electrocifiligrama/ASSD-TP3/sigmaDelta/sigmaDeltaAltium/Project Outputs for sigmaDeltaAltium/Board Information - sigmaDelta.txt

Board Information Report
Filename     : C:\Users\malen\Desktop\ASSD\TP3aux\sigmaDeltaAltium\sigmaDelta.PcbDoc
Date         : 27/5/2019
Time         : 15:24:40
Time Elapsed : 00:00:00

General
    Board Size, 152.4mmx101.6mm
    Components on board, 68
count : 2

Routing Information
    Routing completion, 97,11%
    Connections, 173
    Connections routed, 168
    Connections remaining, 5
count : 4
