electrocifiligrama/ASSD-TP3/sigmaDelta/sigmaDeltaAltium/Project Outputs for sigmaDeltaAltium/Board Information - sigmaDeltaAUX.txt

Board Information Report
Filename     : C:\Users\malen\Desktop\ASSD\TP3aux\sigmaDeltaAltium\sigmaDeltaAUX.PcbDoc
Date         : 29/5/2019
Time         : 09:48:44
Time Elapsed : 00:00:00

General
    Board Size, 100mmx100.07mm
    Components on board, 68
count : 2

Routing Information
    Routing completion, 100,00%
    Connections, 173
    Connections routed, 173
    Connections remaining, 0
count : 4
