electrocifiligrama/ASSD-TP3/informe/filtros/caps.PNG

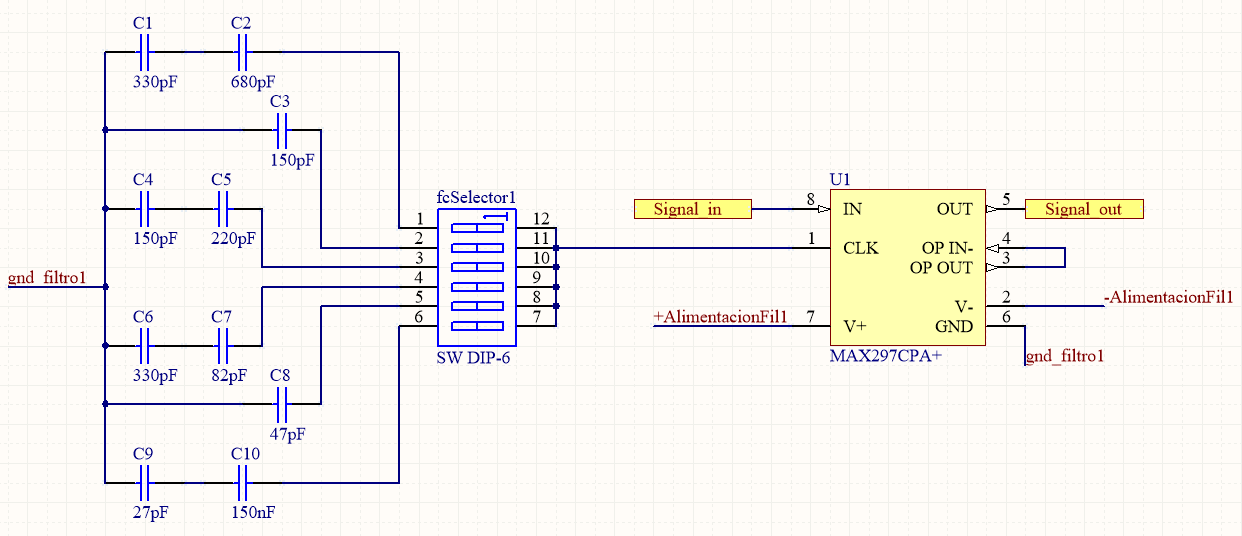
informe/filtros/caps.PNG
