electrocifiligrama/ASSD-TP3/informe/filtros/datosfiltro.PNG

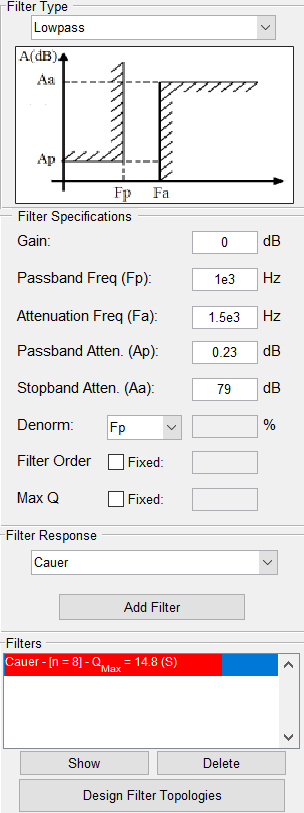
informe/filtros/datosfiltro.PNG
