electrocifiligrama/ASSD-TP3/informe/filtros/ellipticFilterResponse.PNG

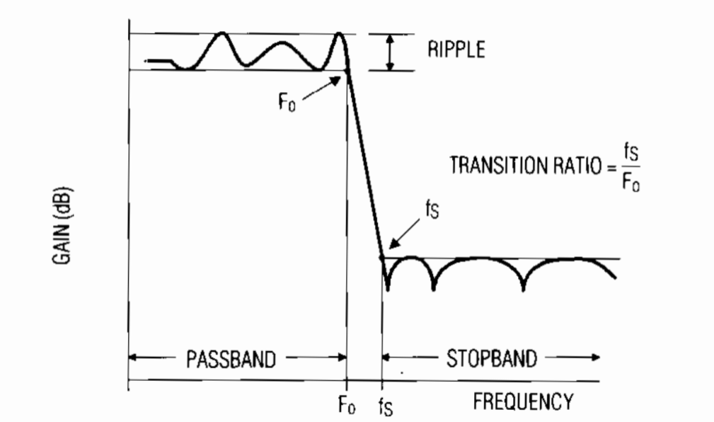
informe/filtros/ellipticFilterResponse.PNG
