electrocifiligrama/ASSD-TP3/informe/filtros/freqResponse.PNG

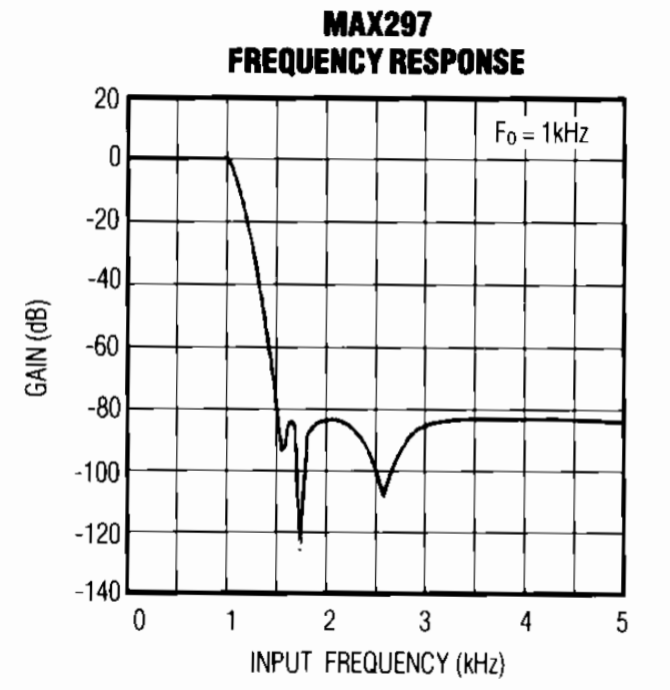
informe/filtros/freqResponse.PNG
