electrocifiligrama/ASSD-TP3/informe/filtros/magbode.PNG

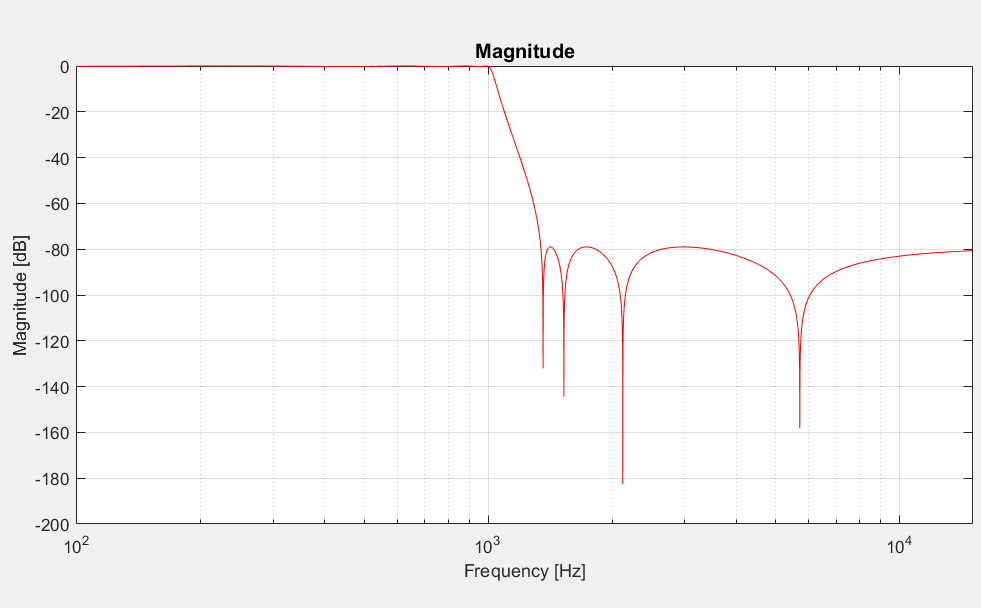
informe/filtros/magbode.PNG
