electrocifiligrama/ASSD-TP3/informe/filtros/magbodeZoom.PNG

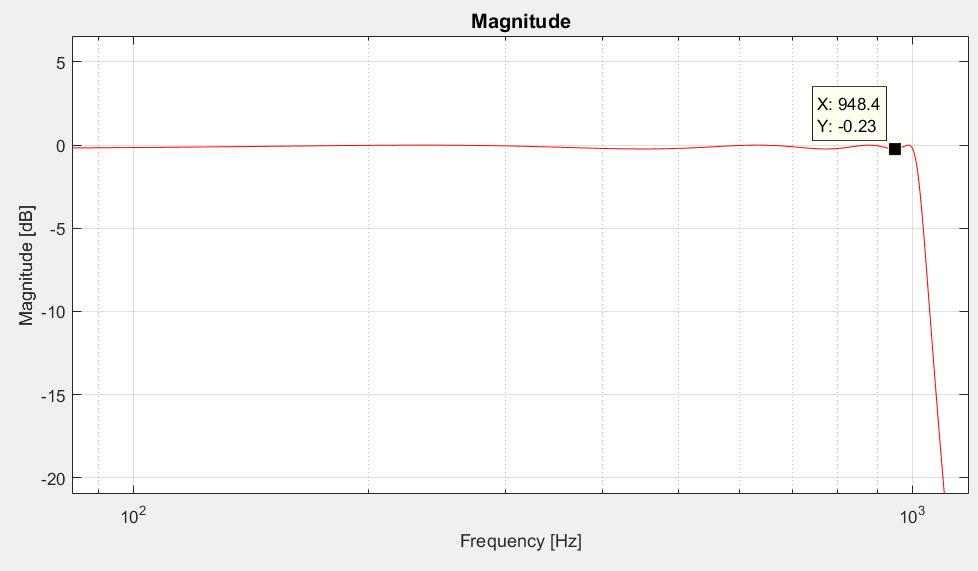
informe/filtros/magbodeZoom.PNG
