electrocifiligrama/ASSD-TP3/informe/filtros/phasebode.PNG

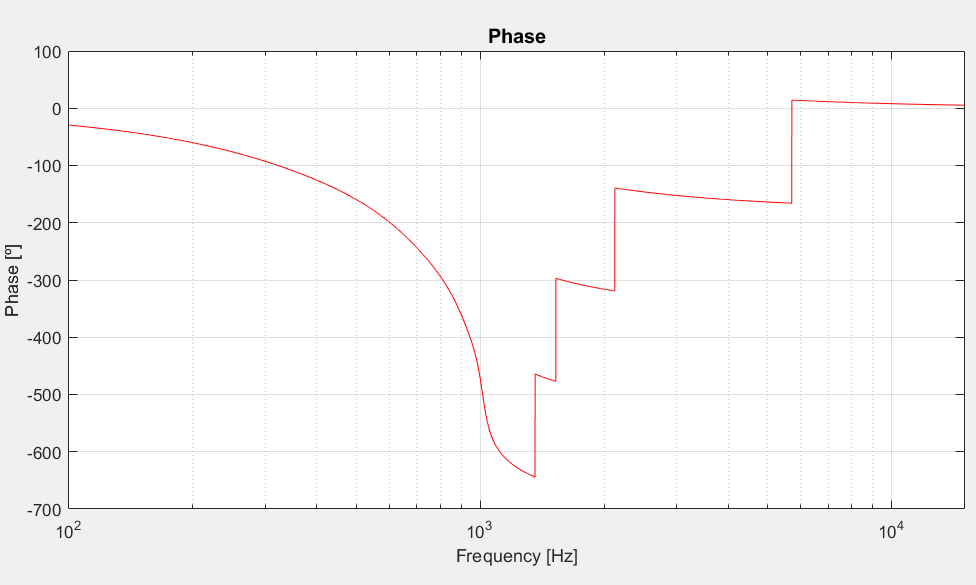
informe/filtros/phasebode.PNG
