electrocifiligrama/ASSD-TP3/informe/filtros/phaseResponse.PNG

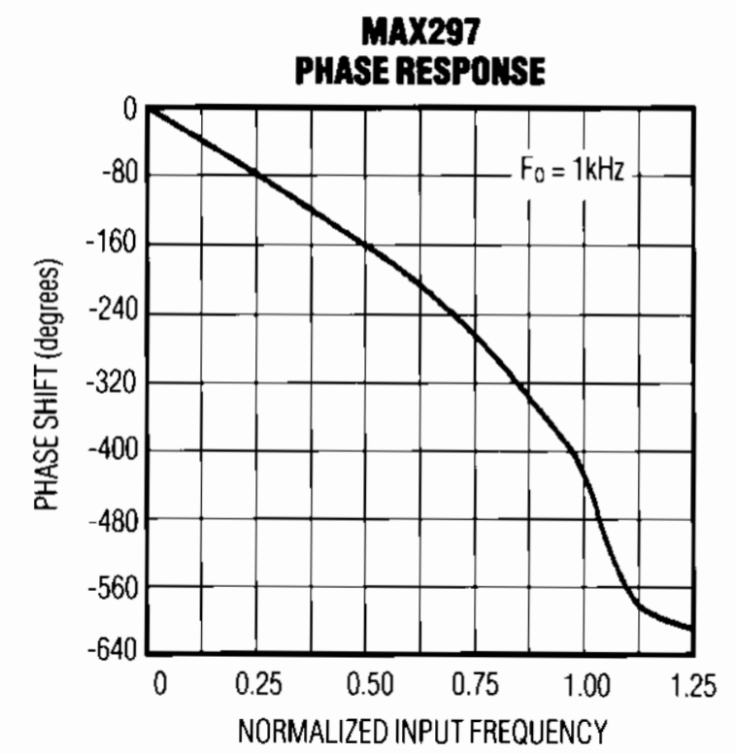
informe/filtros/phaseResponse.PNG
