electrocifiligrama/ASSD-TP3/informe/filtros/polezeromap.PNG

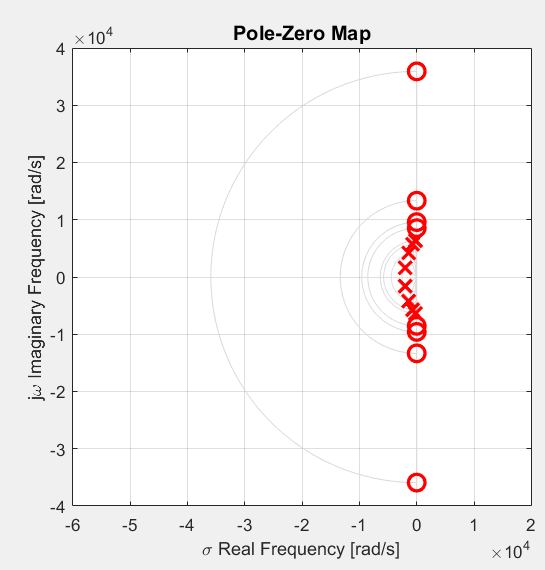
informe/filtros/polezeromap.PNG
