electrocifiligrama/ASSD-TP3/informe/imagenes/ada.PNG

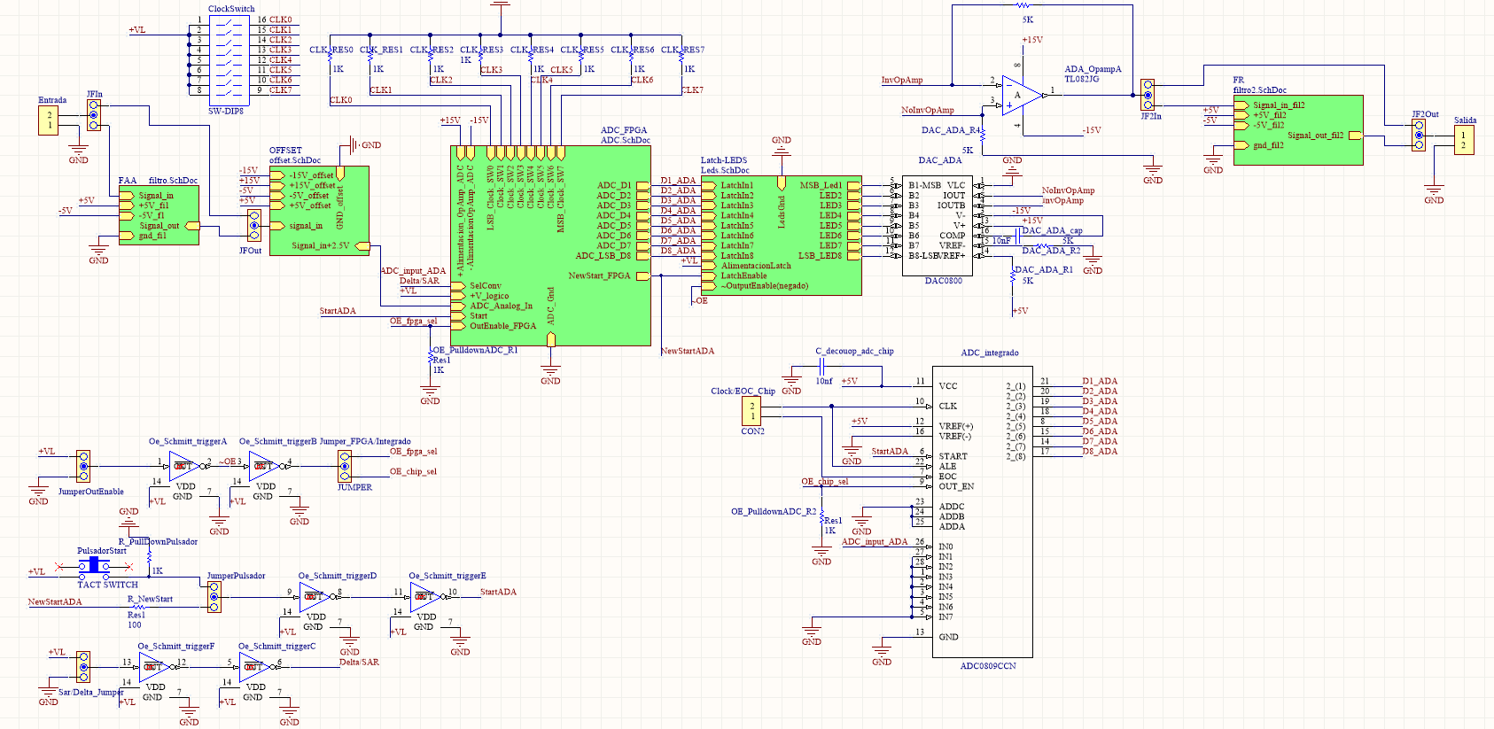
informe/imagenes/ada.PNG
