electrocifiligrama/ASSD-TP3/informe/imagenes/dacOut.PNG

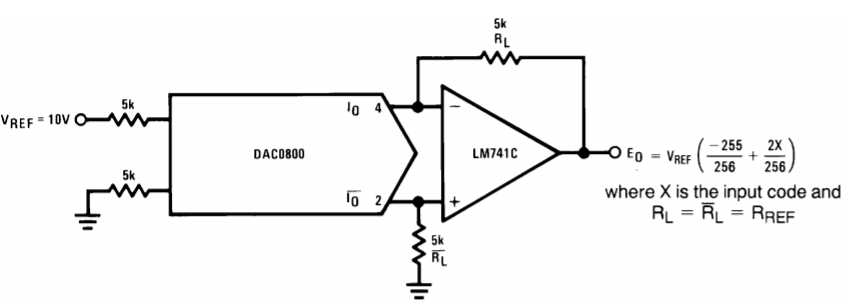
informe/imagenes/dacOut.PNG
