electrocifiligrama/ASSD-TP3/informe/imagenes/offset.PNG

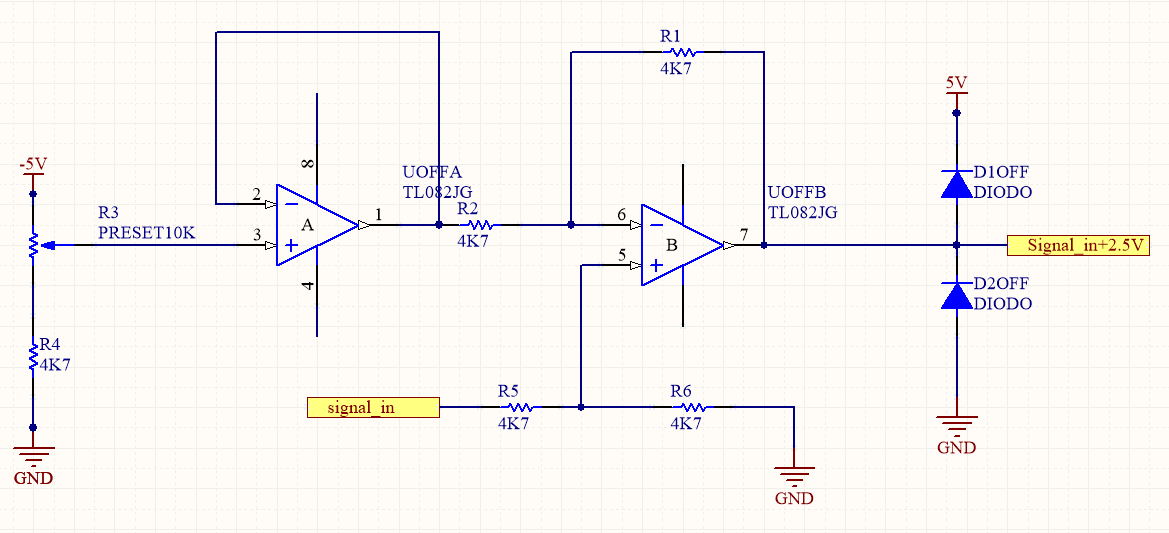
informe/imagenes/offset.PNG
