electrocifiligrama/ASSD-TP3/informe/imagenes/Screenshot 2019-06-12 13.05.55.png

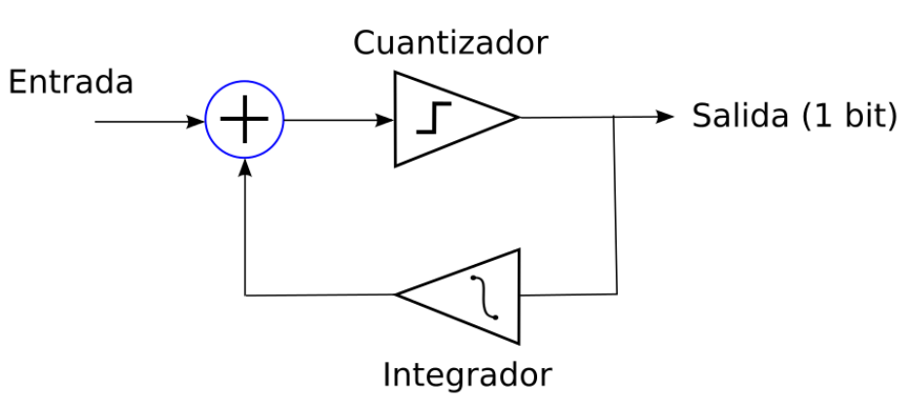
informe/imagenes/Screenshot 2019-06-12 13.05.55.png
