electrocifiligrama/ASSD-TP3/informe/imagenes/Screenshot 2019-06-12 13.13.50.png

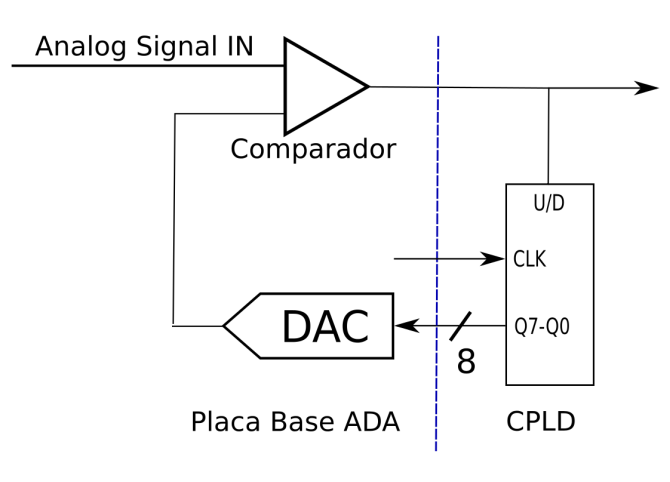
informe/imagenes/Screenshot 2019-06-12 13.13.50.png
