electrocifiligrama/ASSD-TP3/SAR/Informe/Imágenes/bits_notacion.png

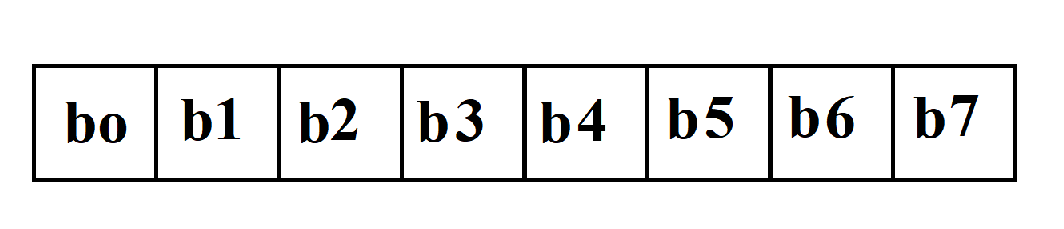
SAR/Informe/Imágenes/bits_notacion.png
