electrocifiligrama/ASSD-TP3/SAR/Informe/Imágenes/sample_hold_times.png

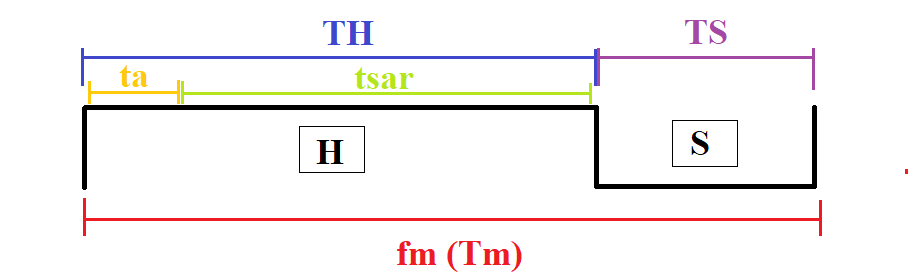
SAR/Informe/Imágenes/sample_hold_times.png
