electrocifiligrama/ASSD-TP3/SAR/Informe/Imágenes/sample_hold_times_final.png

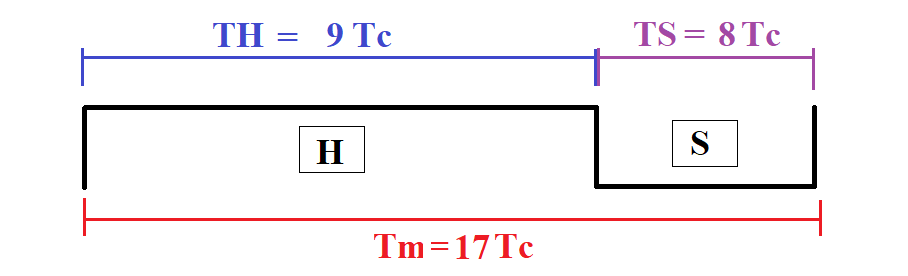
SAR/Informe/Imágenes/sample_hold_times_final.png
