electrocifiligrama/ASSD-TP3/sigmaDelta/imagenesSIGMADELTA/decimadorFIR.PNG

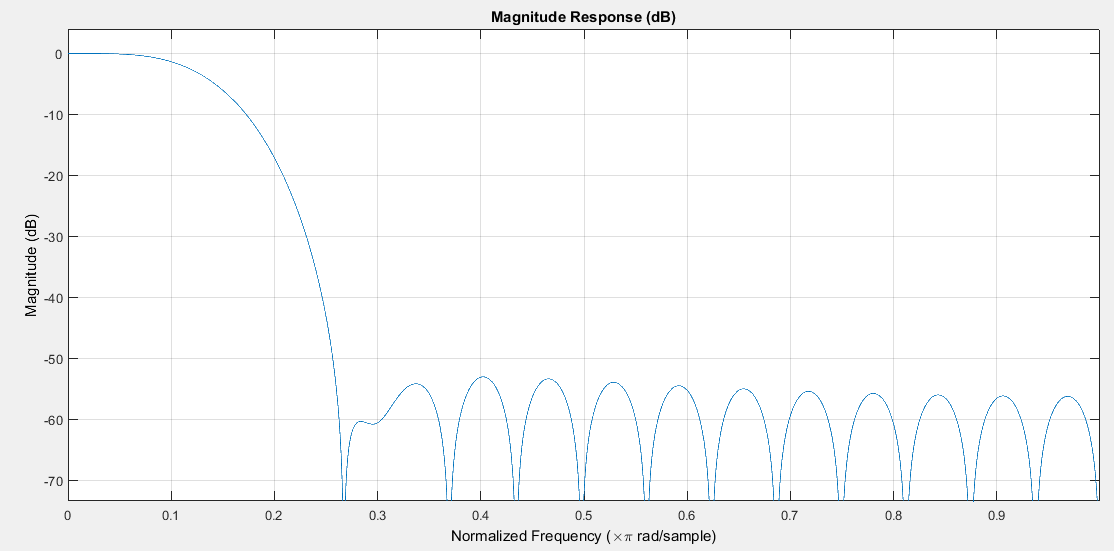
sigmaDelta/imagenesSIGMADELTA/decimadorFIR.PNG
