electrocifiligrama/ASSD-TP3/sigmaDelta/imagenesSIGMADELTA/delta2sigmadelta1.PNG

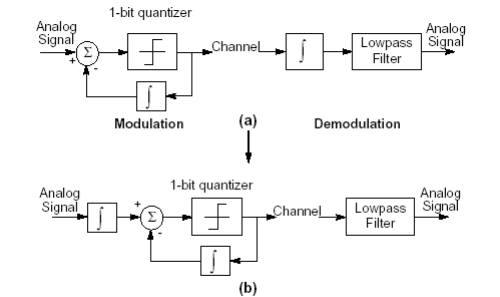
sigmaDelta/imagenesSIGMADELTA/delta2sigmadelta1.PNG
