electrocifiligrama/ASSD-TP3/sigmaDelta/imagenesSIGMADELTA/delta2sigmadelta2.PNG

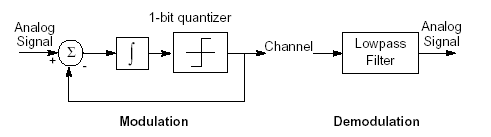
sigmaDelta/imagenesSIGMADELTA/delta2sigmadelta2.PNG
