electrocifiligrama/ASSD-TP3/sigmaDelta/imagenesSIGMADELTA/espectroMedioGauss.PNG

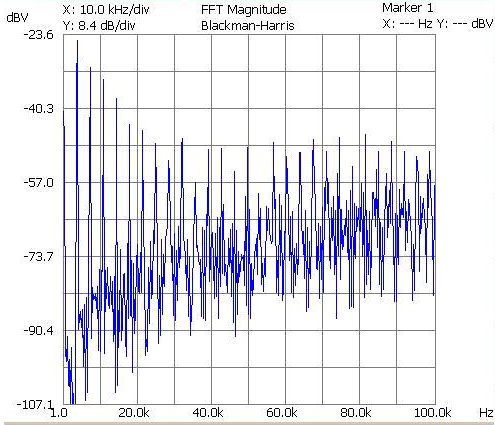
sigmaDelta/imagenesSIGMADELTA/espectroMedioGauss.PNG
