electrocifiligrama/ASSD-TP3/sigmaDelta/imagenesSIGMADELTA/espectroSen1KHzSimulink.PNG

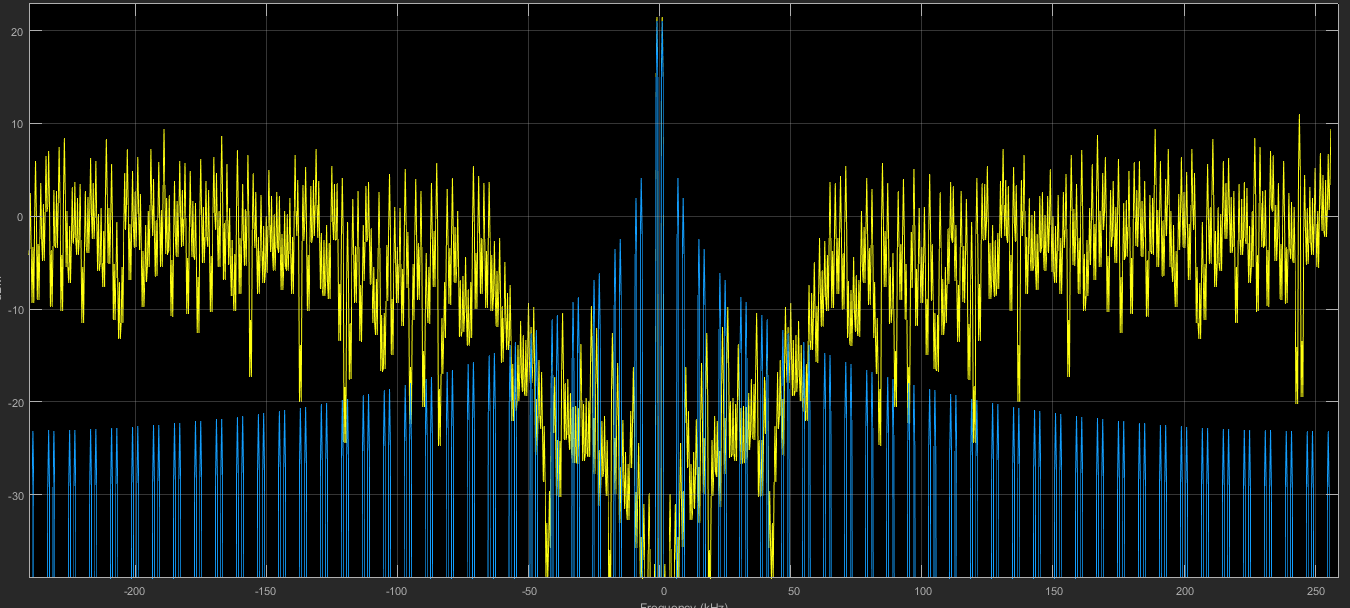
sigmaDelta/imagenesSIGMADELTA/espectroSen1KHzSimulink.PNG
