electrocifiligrama/ASSD-TP3/sigmaDelta/imagenesSIGMADELTA/espectroSeno.PNG

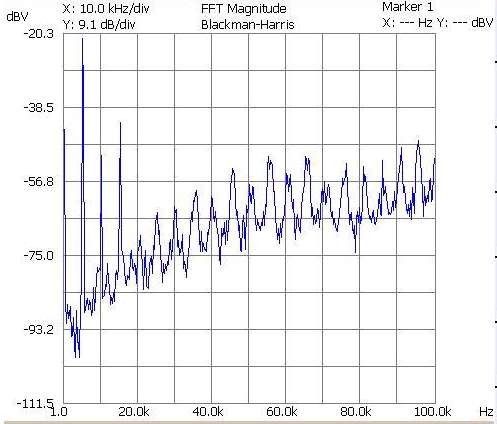
sigmaDelta/imagenesSIGMADELTA/espectroSeno.PNG
