electrocifiligrama/ASSD-TP3/sigmaDelta/imagenesSIGMADELTA/espectroShaped.PNG

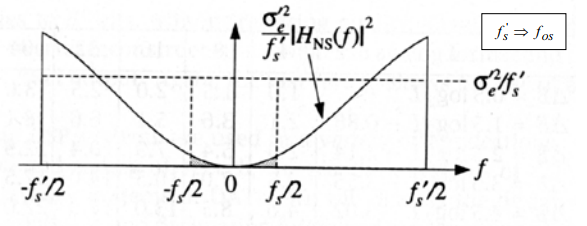
sigmaDelta/imagenesSIGMADELTA/espectroShaped.PNG
