electrocifiligrama/ASSD-TP3/sigmaDelta/imagenesSIGMADELTA/espectroSimulink.PNG

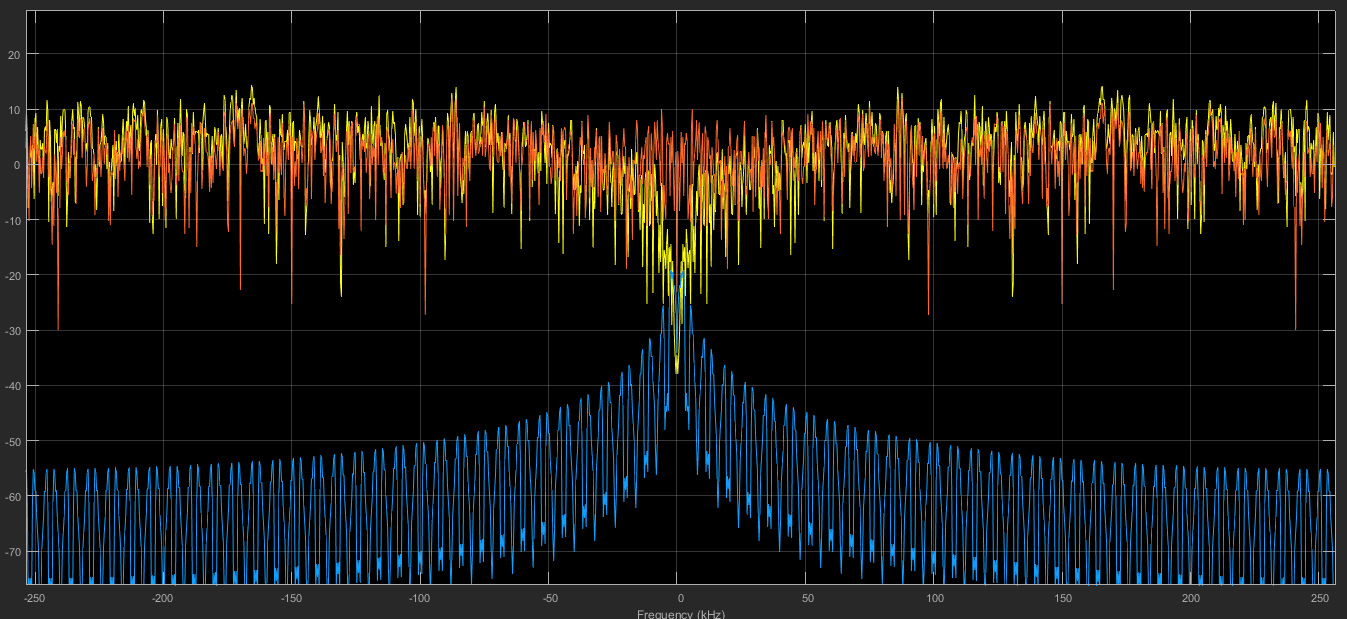
sigmaDelta/imagenesSIGMADELTA/espectroSimulink.PNG
