electrocifiligrama/ASSD-TP3/sigmaDelta/imagenesSIGMADELTA/espectroSinc.PNG

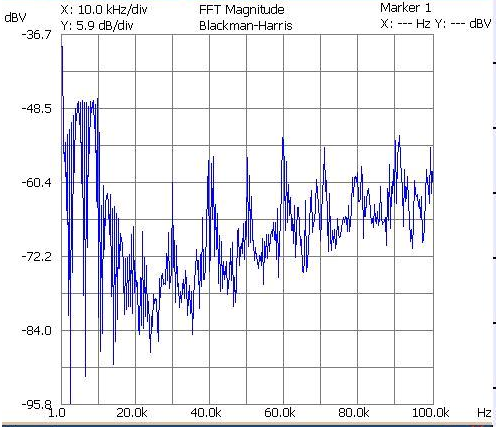
sigmaDelta/imagenesSIGMADELTA/espectroSinc.PNG
