electrocifiligrama/ASSD-TP3/sigmaDelta/imagenesSIGMADELTA/esquemaSIMULINK.PNG

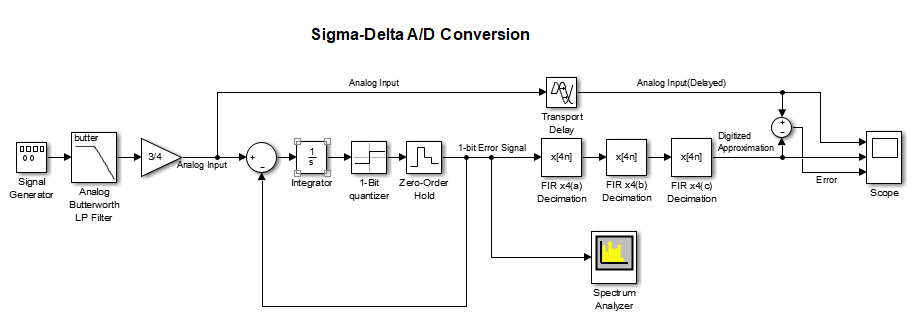
sigmaDelta/imagenesSIGMADELTA/esquemaSIMULINK.PNG
