electrocifiligrama/ASSD-TP3/sigmaDelta/imagenesSIGMADELTA/esquematicoBASE.png

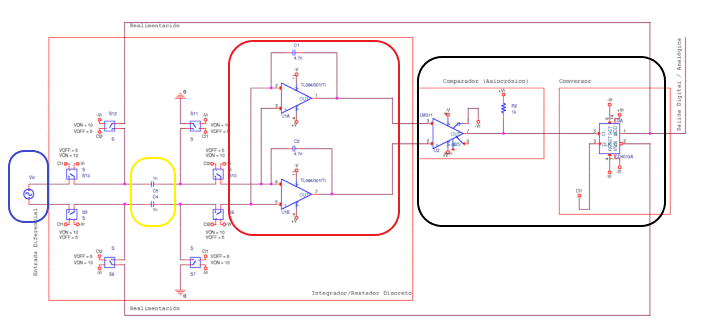
sigmaDelta/imagenesSIGMADELTA/esquematicoBASE.png
