electrocifiligrama/ASSD-TP3/sigmaDelta/imagenesSIGMADELTA/esquematicoBASEsincuadros.PNG

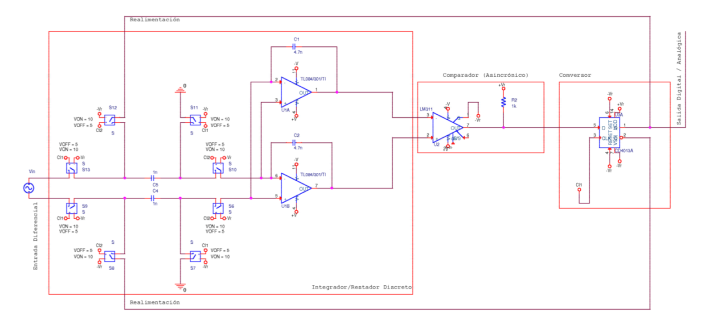
sigmaDelta/imagenesSIGMADELTA/esquematicoBASEsincuadros.PNG
