electrocifiligrama/ASSD-TP3/sigmaDelta/imagenesSIGMADELTA/esquematicoClock.PNG

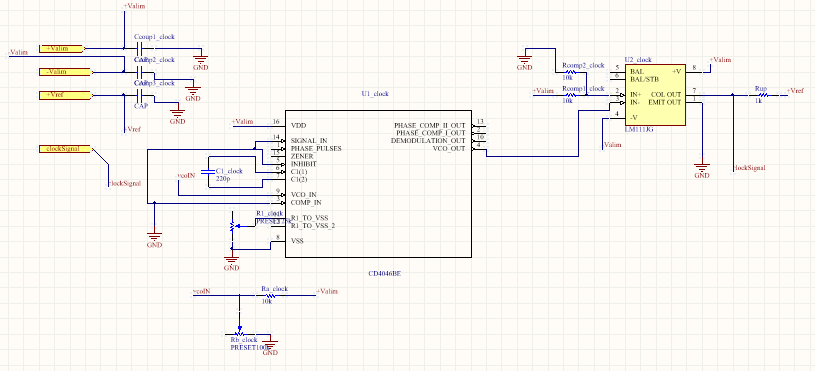
sigmaDelta/imagenesSIGMADELTA/esquematicoClock.PNG
