electrocifiligrama/ASSD-TP3/sigmaDelta/imagenesSIGMADELTA/esquematicoDiff.PNG

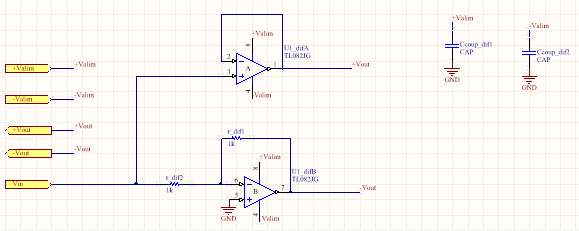
sigmaDelta/imagenesSIGMADELTA/esquematicoDiff.PNG
