electrocifiligrama/ASSD-TP3/sigmaDelta/imagenesSIGMADELTA/esquematicoFiltros.PNG

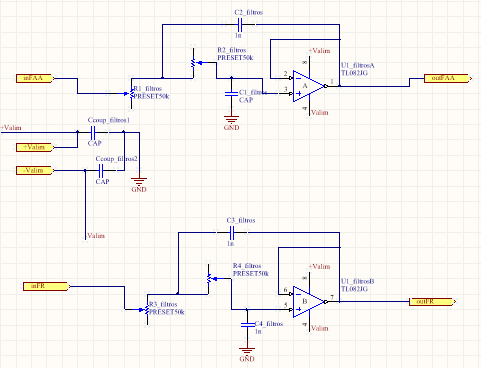
sigmaDelta/imagenesSIGMADELTA/esquematicoFiltros.PNG
