electrocifiligrama/ASSD-TP3/sigmaDelta/imagenesSIGMADELTA/esquematicoGeneral.PNG

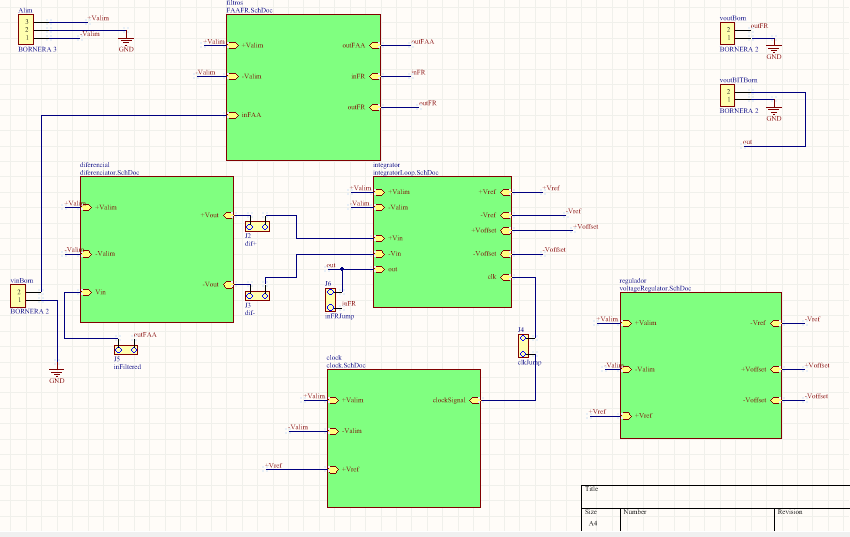
sigmaDelta/imagenesSIGMADELTA/esquematicoGeneral.PNG
