electrocifiligrama/ASSD-TP3/sigmaDelta/imagenesSIGMADELTA/esquematicoGenVref.PNG

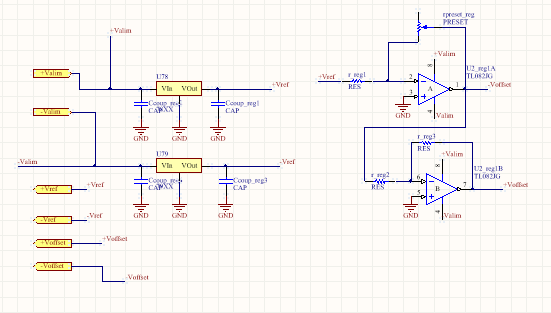
sigmaDelta/imagenesSIGMADELTA/esquematicoGenVref.PNG
