electrocifiligrama/ASSD-TP3/sigmaDelta/imagenesSIGMADELTA/esquematicoIntegrador.PNG

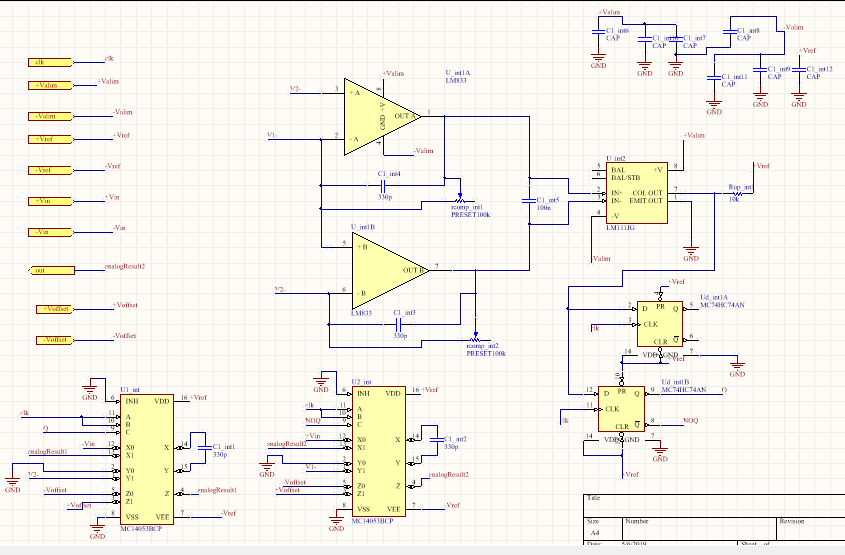
sigmaDelta/imagenesSIGMADELTA/esquematicoIntegrador.PNG
