electrocifiligrama/ASSD-TP3/sigmaDelta/imagenesSIGMADELTA/impulseResponseSimulink.PNG

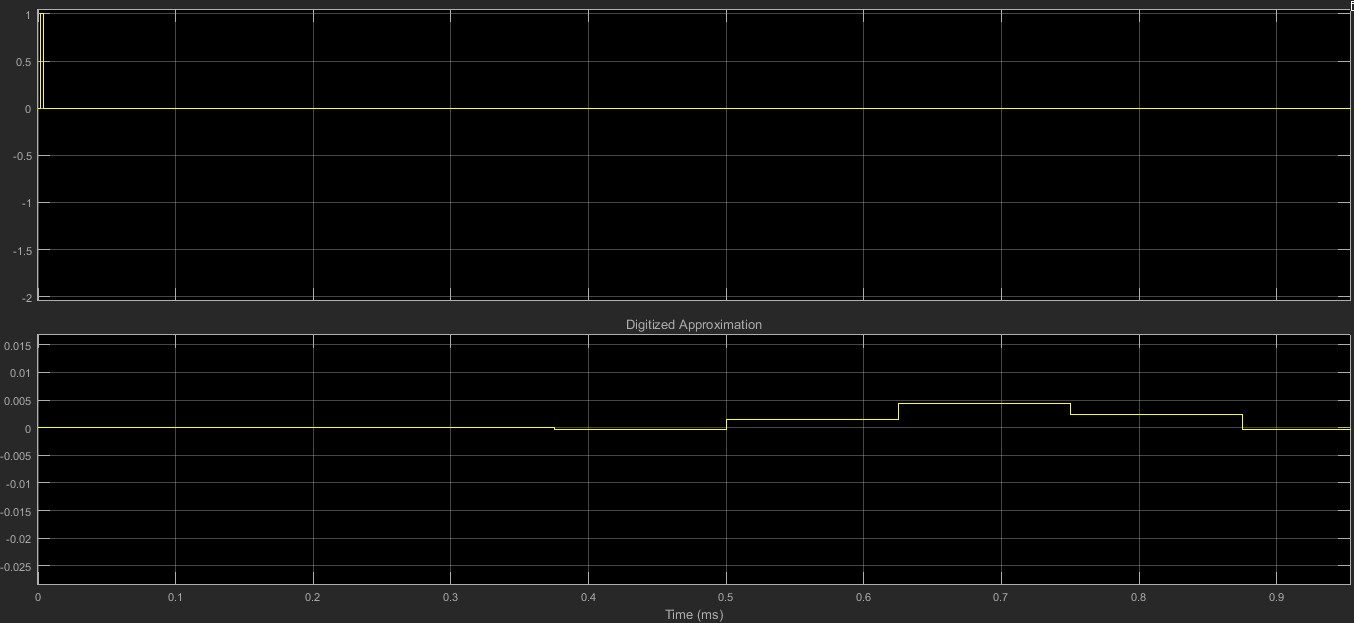
sigmaDelta/imagenesSIGMADELTA/impulseResponseSimulink.PNG
