electrocifiligrama/ASSD-TP3/sigmaDelta/imagenesSIGMADELTA/integradorConRes.PNG

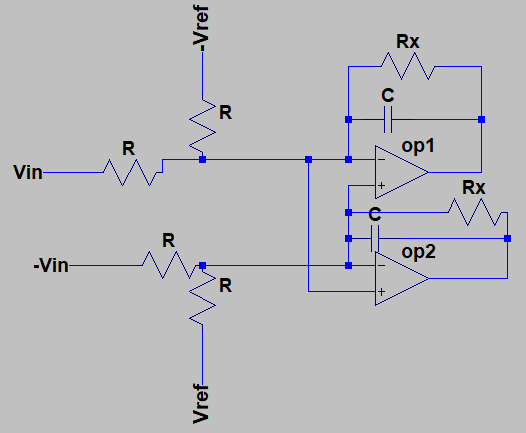
sigmaDelta/imagenesSIGMADELTA/integradorConRes.PNG
