electrocifiligrama/ASSD-TP3/sigmaDelta/imagenesSIGMADELTA/intFinal.PNG

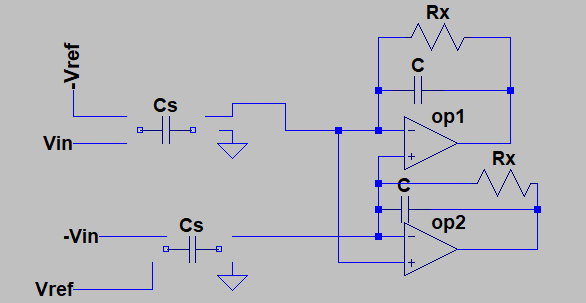
sigmaDelta/imagenesSIGMADELTA/intFinal.PNG
