electrocifiligrama/ASSD-TP3/sigmaDelta/imagenesSIGMADELTA/intHold.PNG

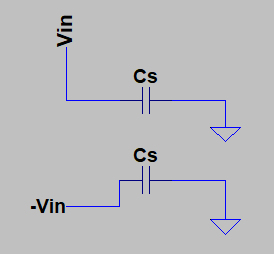
sigmaDelta/imagenesSIGMADELTA/intHold.PNG
