electrocifiligrama/ASSD-TP3/sigmaDelta/imagenesSIGMADELTA/intSample.PNG

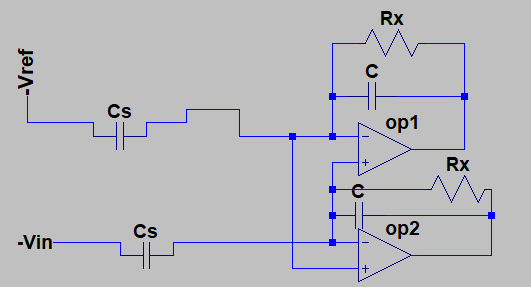
sigmaDelta/imagenesSIGMADELTA/intSample.PNG
