electrocifiligrama/ASSD-TP3/sigmaDelta/imagenesSIGMADELTA/mathModelDiagram.PNG

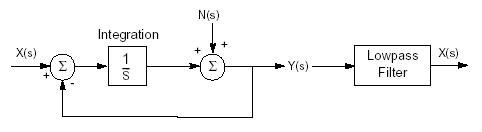
sigmaDelta/imagenesSIGMADELTA/mathModelDiagram.PNG
