electrocifiligrama/ASSD-TP3/sigmaDelta/imagenesSIGMADELTA/medioGaussAlias.PNG

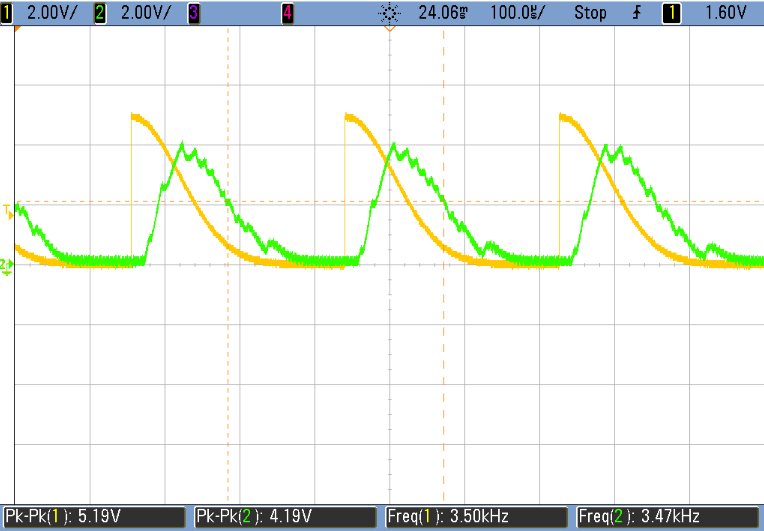
sigmaDelta/imagenesSIGMADELTA/medioGaussAlias.PNG
