electrocifiligrama/ASSD-TP3/sigmaDelta/imagenesSIGMADELTA/medioGaussAverage8.PNG

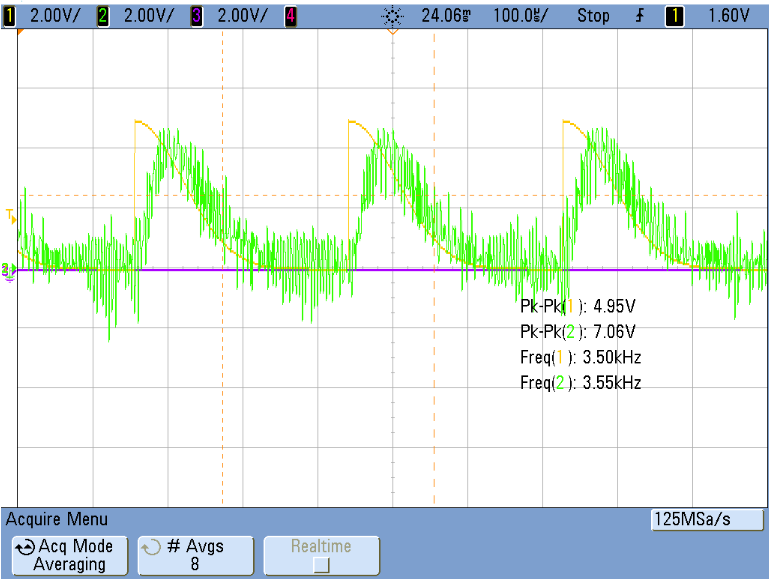
sigmaDelta/imagenesSIGMADELTA/medioGaussAverage8.PNG
