electrocifiligrama/ASSD-TP3/sigmaDelta/imagenesSIGMADELTA/medioGaussAverage4096.PNG

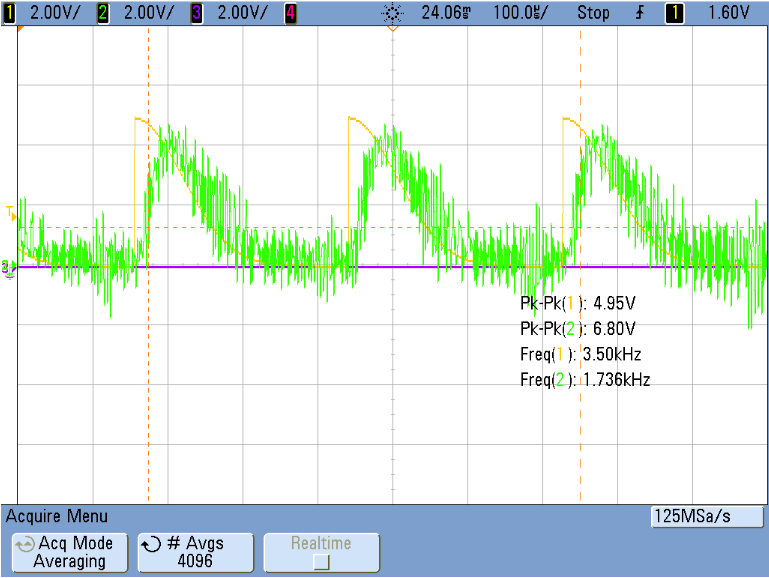
sigmaDelta/imagenesSIGMADELTA/medioGaussAverage4096.PNG
