electrocifiligrama/ASSD-TP3/sigmaDelta/imagenesSIGMADELTA/medioGaussBajaFreq.PNG

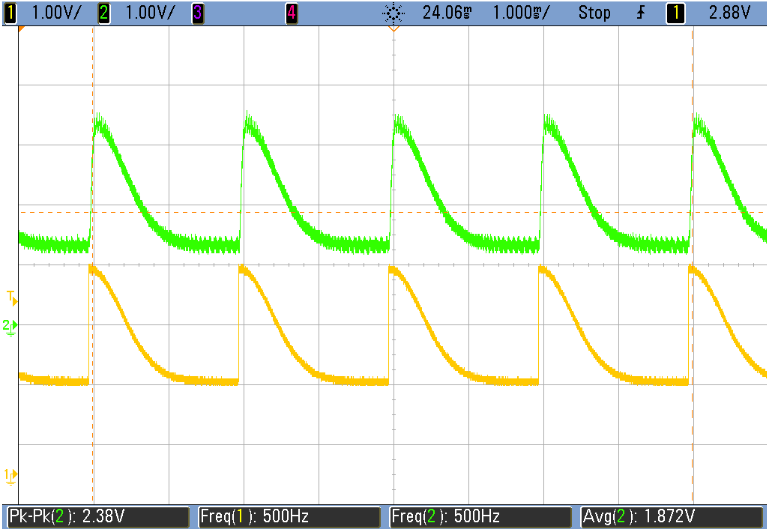
sigmaDelta/imagenesSIGMADELTA/medioGaussBajaFreq.PNG
