electrocifiligrama/ASSD-TP3/sigmaDelta/imagenesSIGMADELTA/medioGaussDifInt.PNG

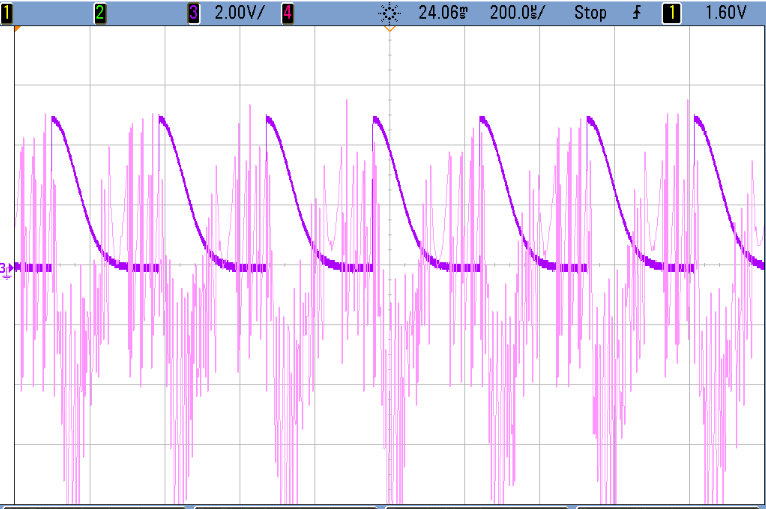
sigmaDelta/imagenesSIGMADELTA/medioGaussDifInt.PNG
