electrocifiligrama/ASSD-TP3/sigmaDelta/imagenesSIGMADELTA/medioGaussDigitalizada.PNG

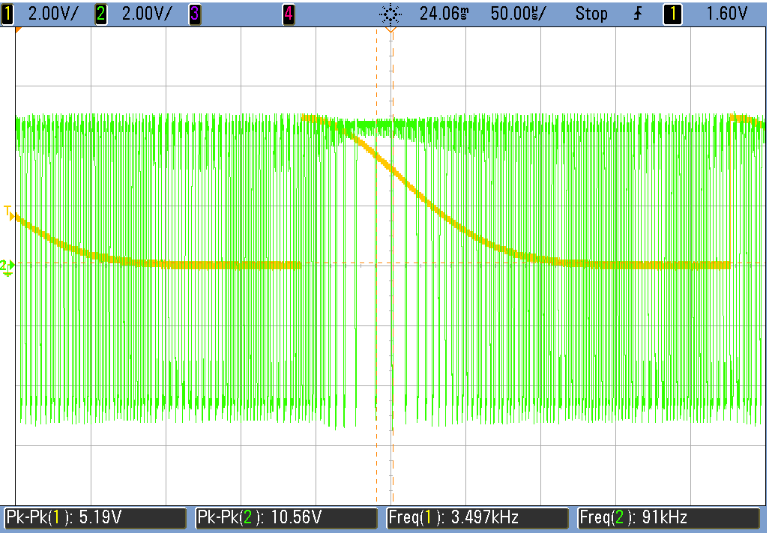
sigmaDelta/imagenesSIGMADELTA/medioGaussDigitalizada.PNG
