electrocifiligrama/ASSD-TP3/sigmaDelta/imagenesSIGMADELTA/medioGaussFiltrada.PNG

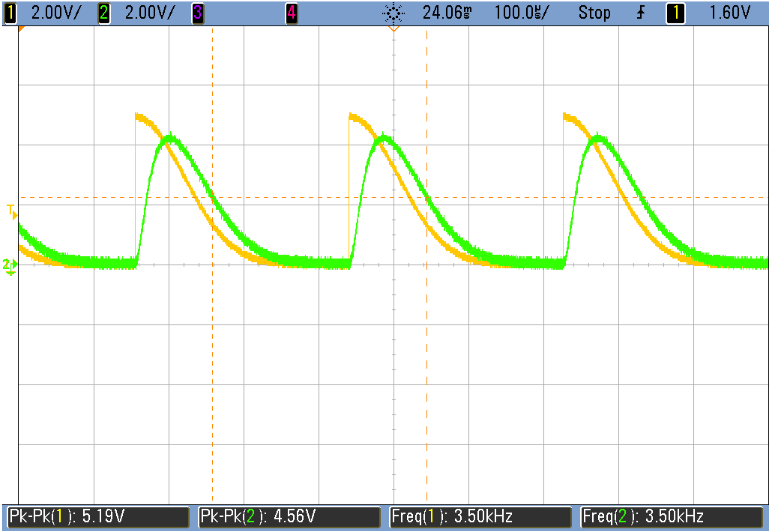
sigmaDelta/imagenesSIGMADELTA/medioGaussFiltrada.PNG
