electrocifiligrama/ASSD-TP3/sigmaDelta/imagenesSIGMADELTA/medioGaussRecuperada.PNG

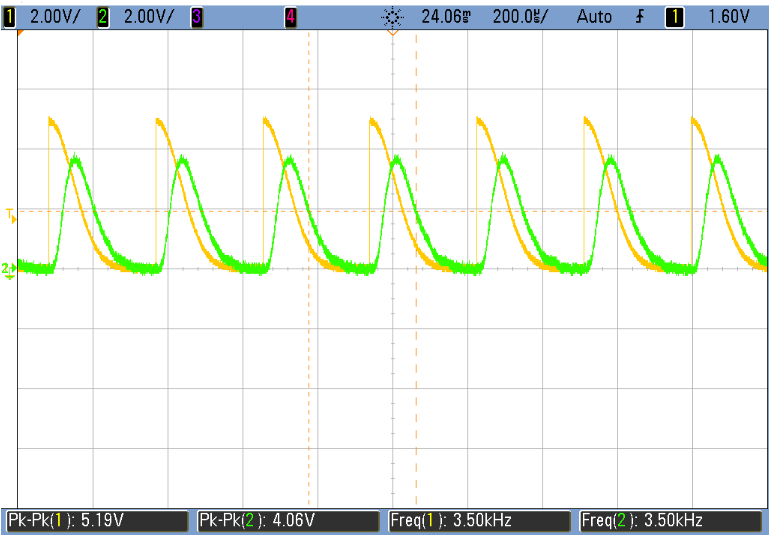
sigmaDelta/imagenesSIGMADELTA/medioGaussRecuperada.PNG
