electrocifiligrama/ASSD-TP3/sigmaDelta/imagenesSIGMADELTA/medioGaussSaturacion.PNG

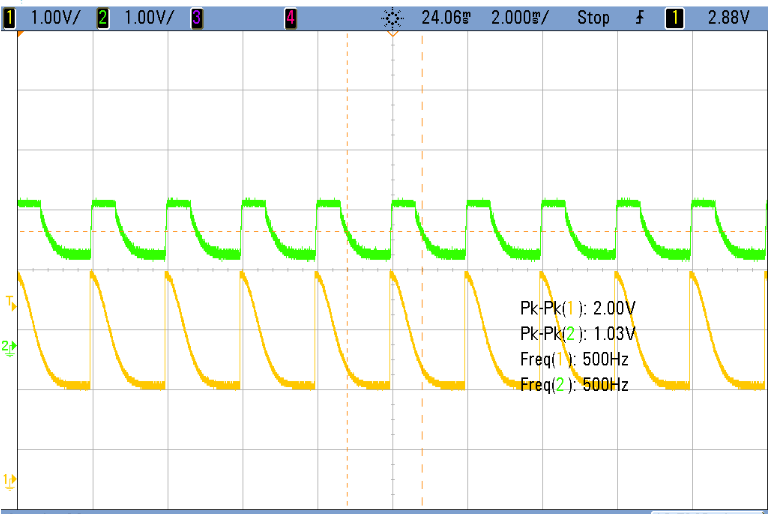
sigmaDelta/imagenesSIGMADELTA/medioGaussSaturacion.PNG
