electrocifiligrama/ASSD-TP3/sigmaDelta/imagenesSIGMADELTA/ordenNoiseShaping.PNG

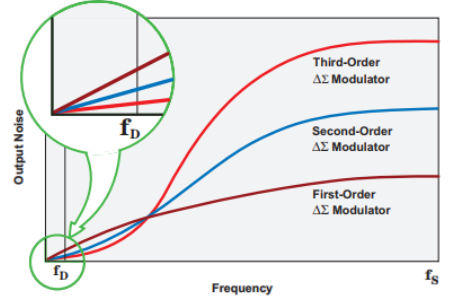
sigmaDelta/imagenesSIGMADELTA/ordenNoiseShaping.PNG
