electrocifiligrama/ASSD-TP3/sigmaDelta/imagenesSIGMADELTA/rtaImpulse1SIMULINK.PNG

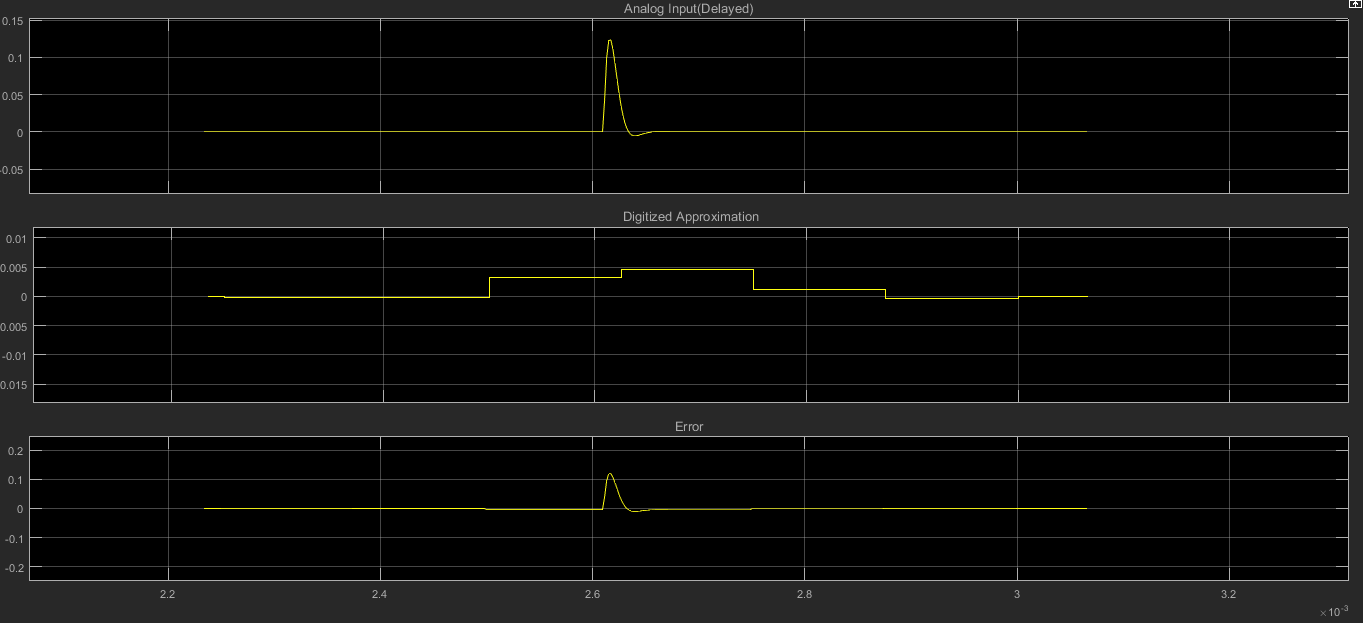
sigmaDelta/imagenesSIGMADELTA/rtaImpulse1SIMULINK.PNG
