electrocifiligrama/ASSD-TP3/sigmaDelta/imagenesSIGMADELTA/senoAlias.PNG

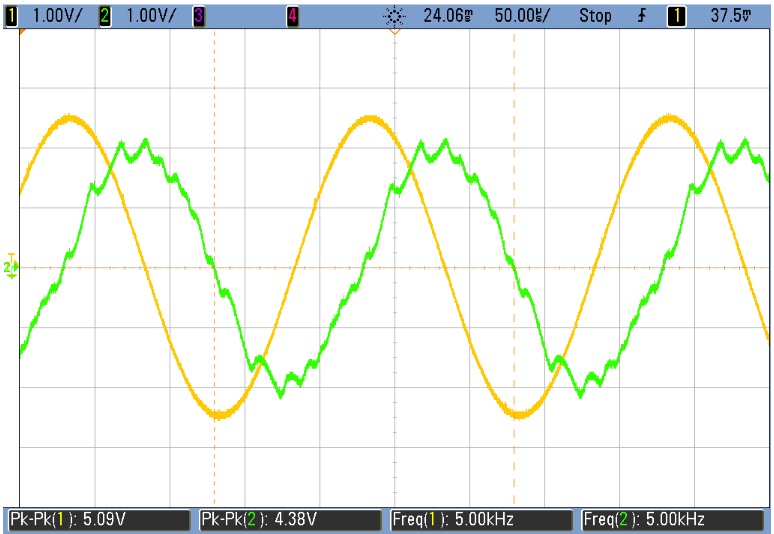
sigmaDelta/imagenesSIGMADELTA/senoAlias.PNG
