electrocifiligrama/ASSD-TP3/sigmaDelta/imagenesSIGMADELTA/senoAverage8.PNG

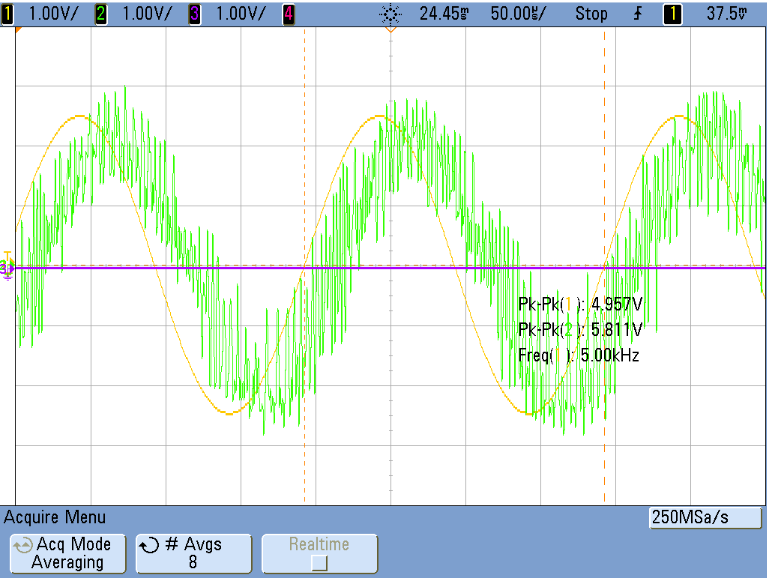
sigmaDelta/imagenesSIGMADELTA/senoAverage8.PNG
