electrocifiligrama/ASSD-TP3/sigmaDelta/imagenesSIGMADELTA/senoDifInt.PNG

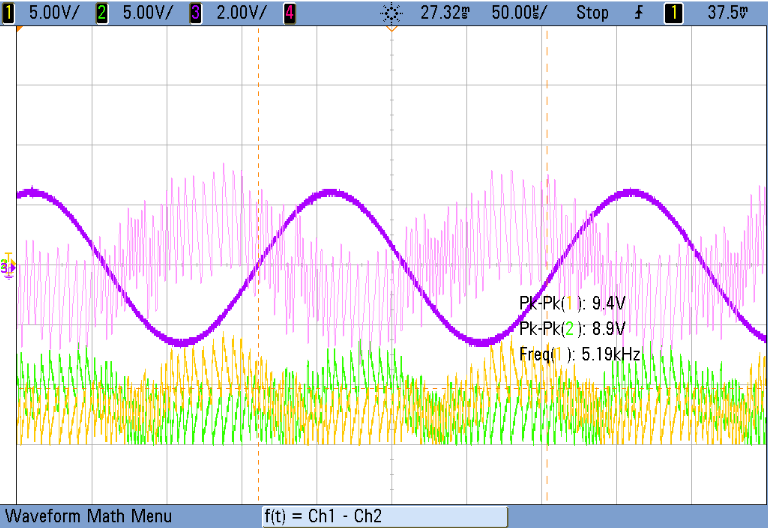
sigmaDelta/imagenesSIGMADELTA/senoDifInt.PNG
