electrocifiligrama/ASSD-TP3/sigmaDelta/imagenesSIGMADELTA/senoDigitalizada.PNG

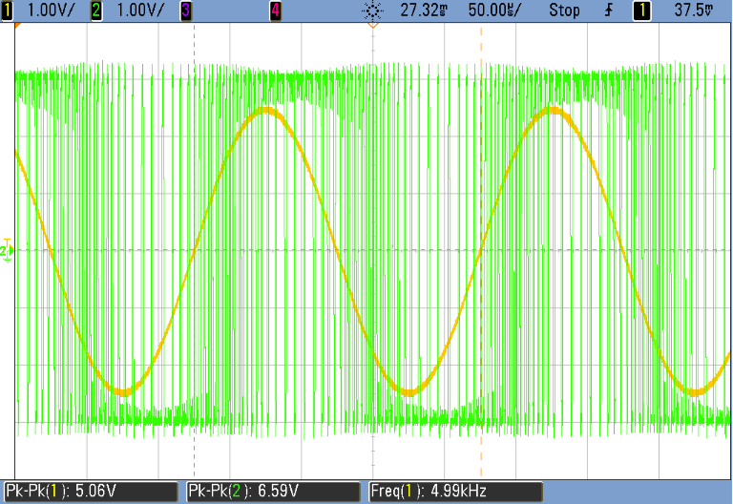
sigmaDelta/imagenesSIGMADELTA/senoDigitalizada.PNG
