electrocifiligrama/ASSD-TP3/sigmaDelta/imagenesSIGMADELTA/senoRecuperada.PNG

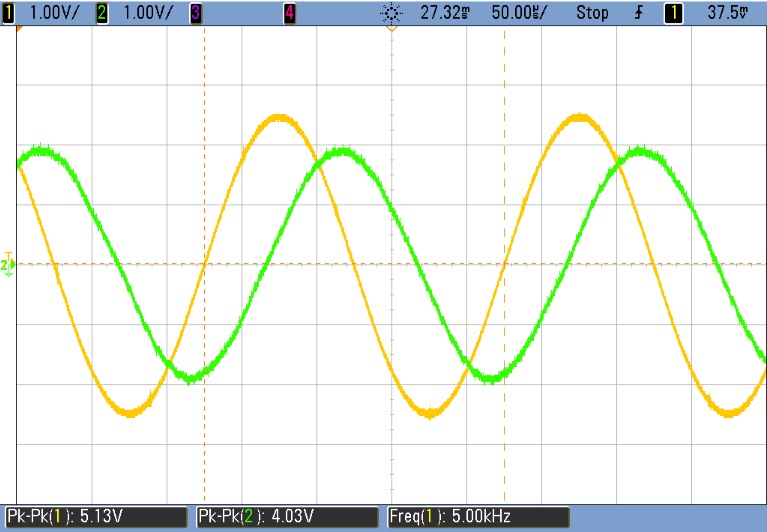
sigmaDelta/imagenesSIGMADELTA/senoRecuperada.PNG
