electrocifiligrama/ASSD-TP3/sigmaDelta/imagenesSIGMADELTA/separacionBandasFreq.PNG

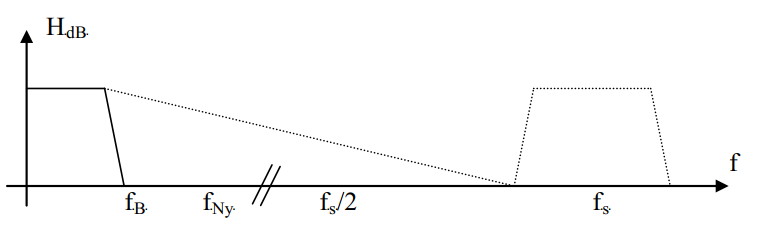
sigmaDelta/imagenesSIGMADELTA/separacionBandasFreq.PNG
