electrocifiligrama/ASSD-TP3/sigmaDelta/imagenesSIGMADELTA/sincAlias.PNG

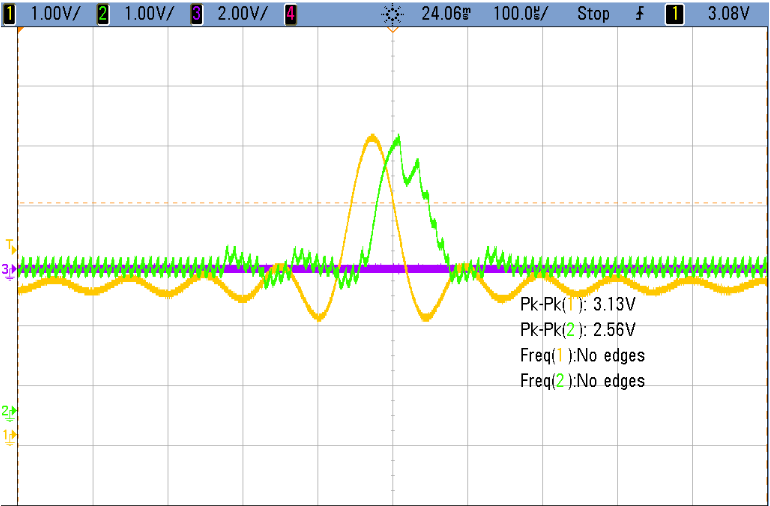
sigmaDelta/imagenesSIGMADELTA/sincAlias.PNG
