electrocifiligrama/ASSD-TP3/sigmaDelta/imagenesSIGMADELTA/sincAtenuada.PNG

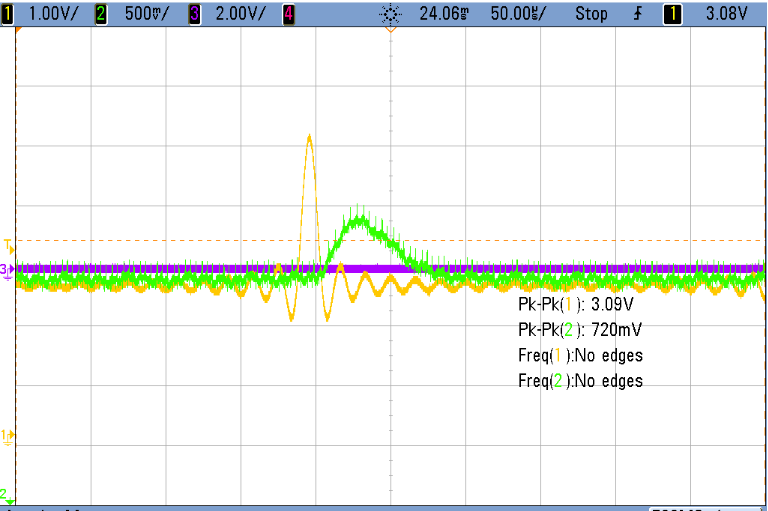
sigmaDelta/imagenesSIGMADELTA/sincAtenuada.PNG
