electrocifiligrama/ASSD-TP3/sigmaDelta/imagenesSIGMADELTA/sincAverage8.PNG

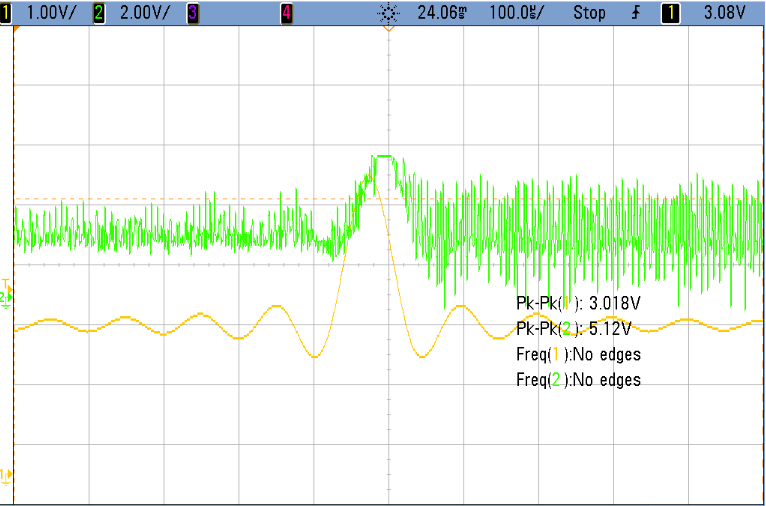
sigmaDelta/imagenesSIGMADELTA/sincAverage8.PNG
