electrocifiligrama/ASSD-TP3/sigmaDelta/imagenesSIGMADELTA/sincAverage4096.PNG

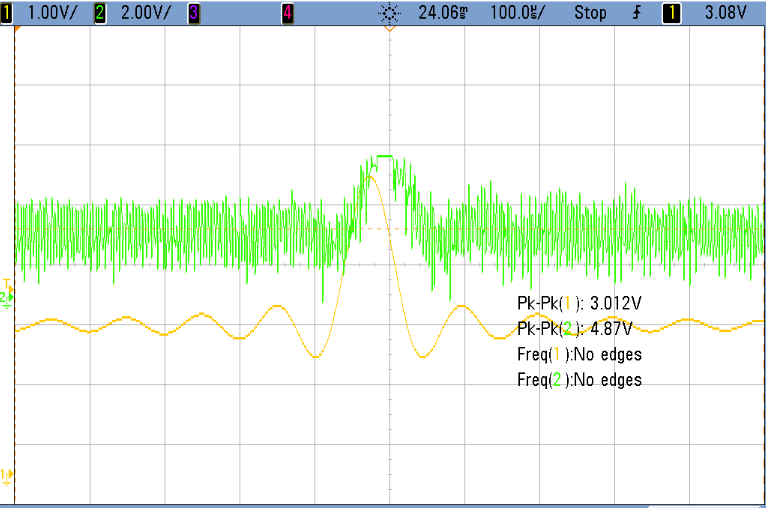
sigmaDelta/imagenesSIGMADELTA/sincAverage4096.PNG
