electrocifiligrama/ASSD-TP3/sigmaDelta/imagenesSIGMADELTA/sincDifInt.PNG

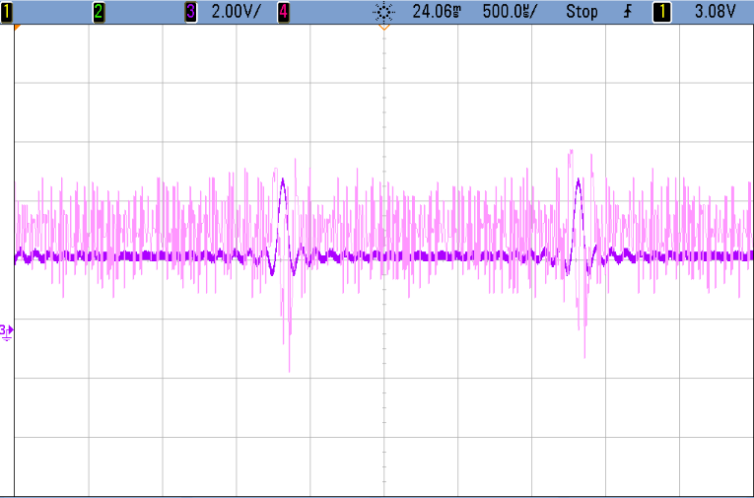
sigmaDelta/imagenesSIGMADELTA/sincDifInt.PNG
