electrocifiligrama/ASSD-TP3/sigmaDelta/imagenesSIGMADELTA/sincDigitalizada.PNG

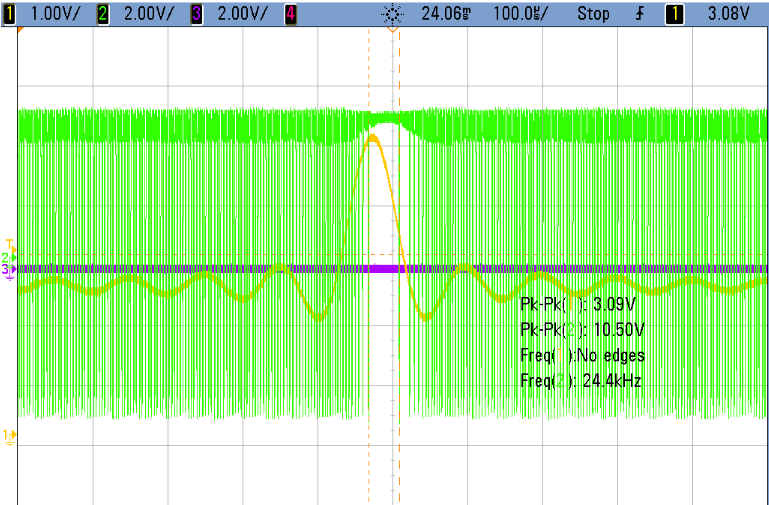
sigmaDelta/imagenesSIGMADELTA/sincDigitalizada.PNG
