electrocifiligrama/ASSD-TP3/Placa_ADA/ADA_Bottom.pdf

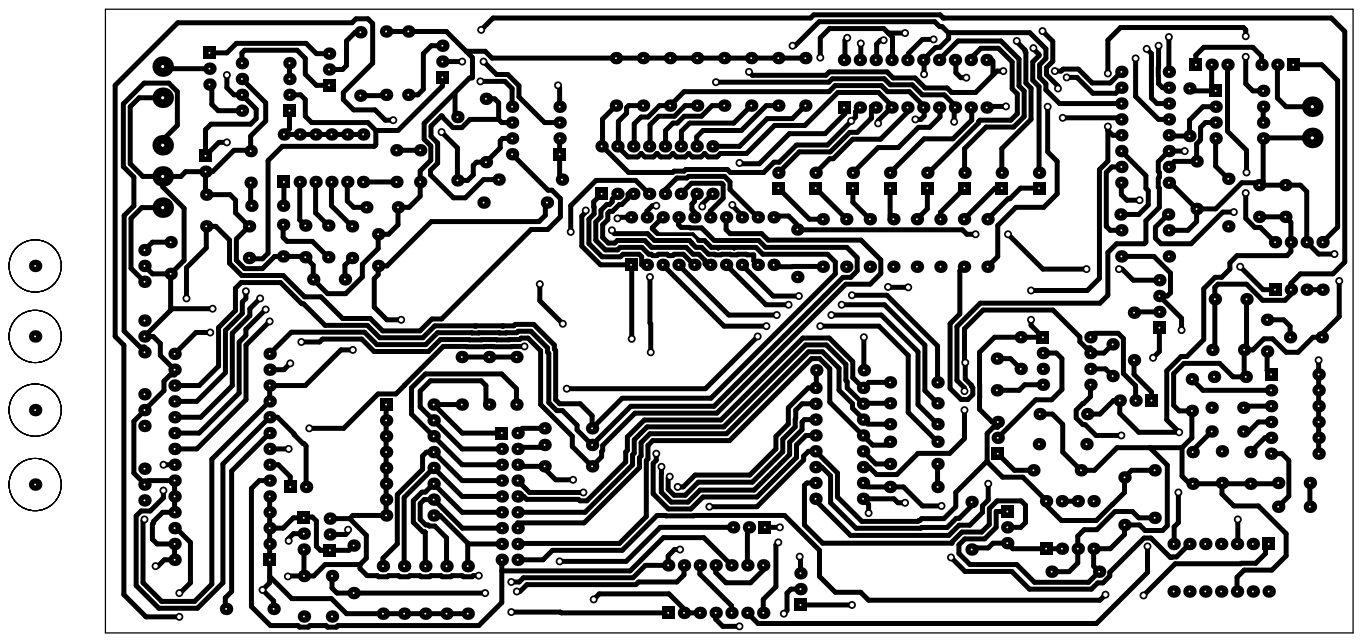
[picture p69: page 1]
