electrocifiligrama/ASSD-TP3/Placa_ADA/ADA_Top.pdf

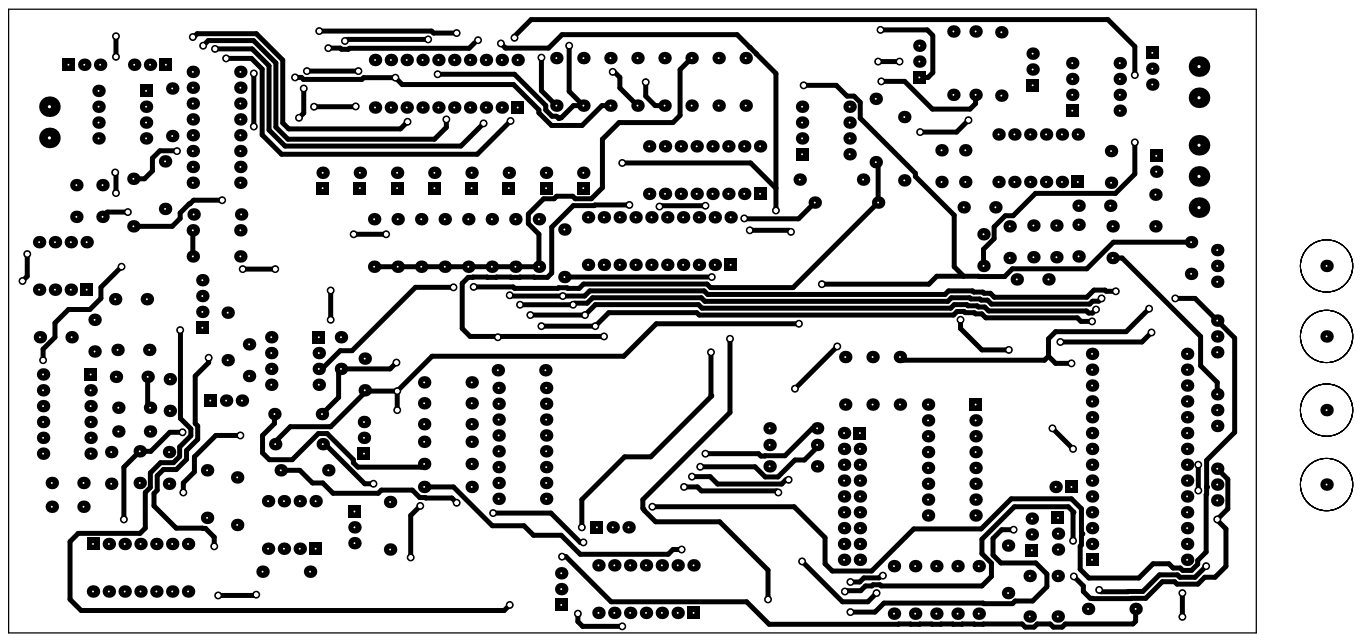
[picture p70: page 1]
