electrocifiligrama/ASSD-TP3/sigmaDelta/sigmaDeltaAltium/bottom.pdf

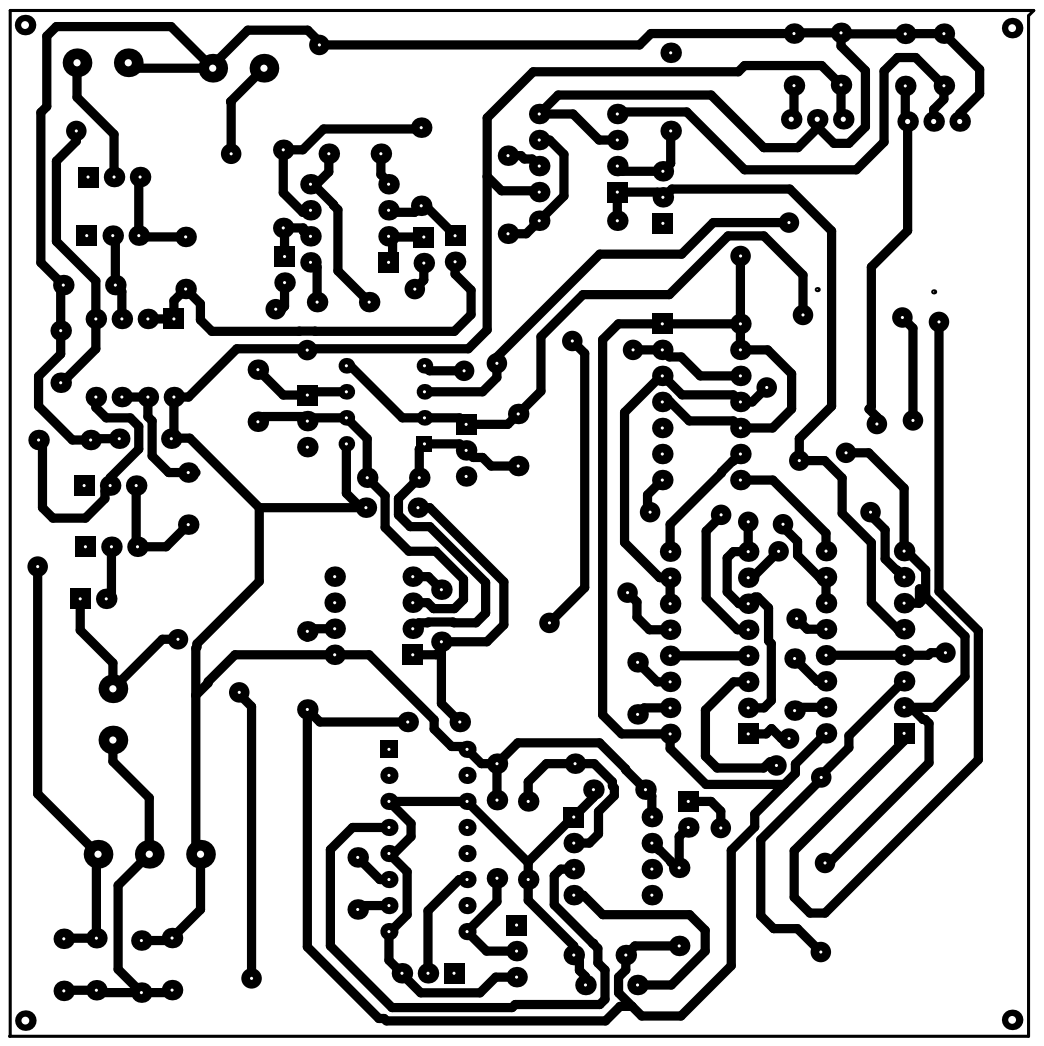
[picture p71: page 1]
