electrocifiligrama/ASSD-TP3/sigmaDelta/sigmaDeltaAltium/top.pdf

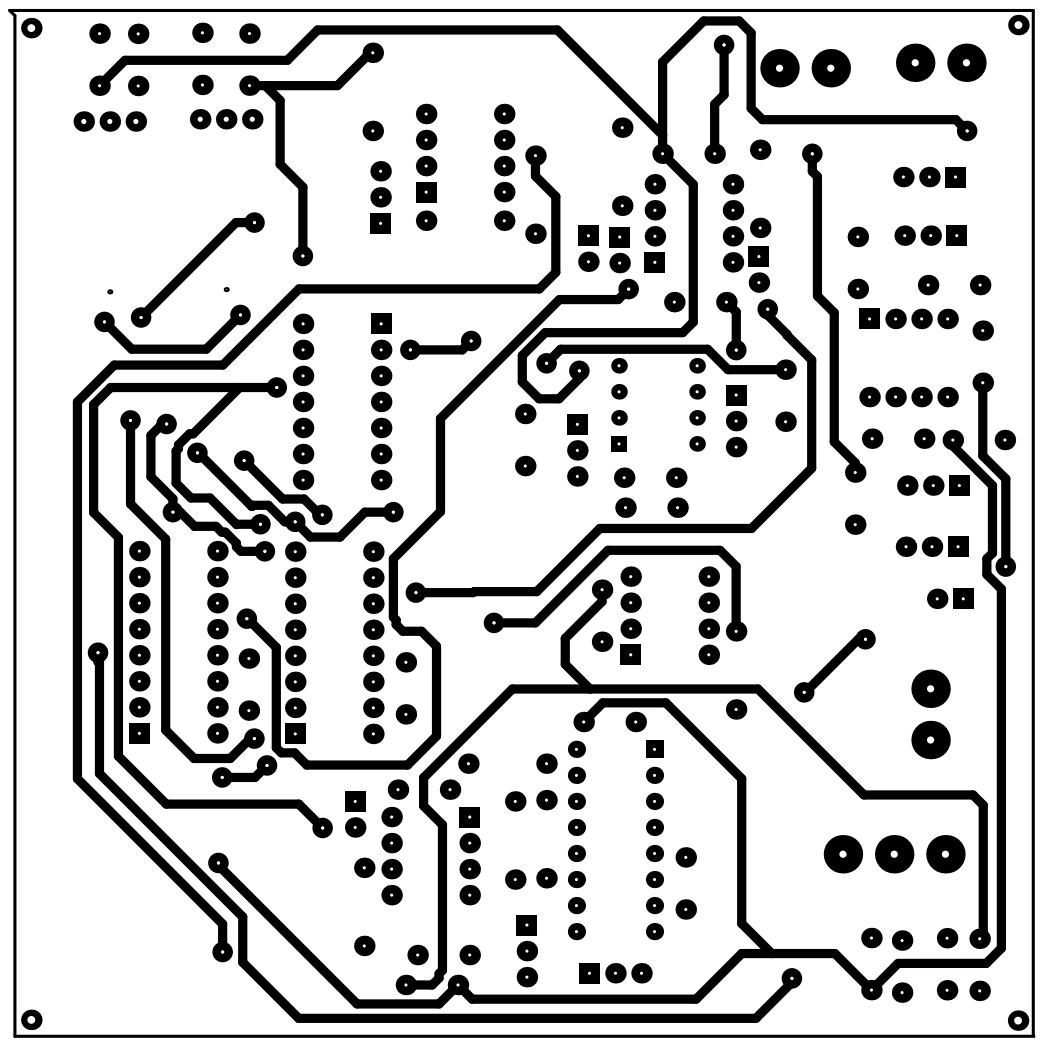
[picture p72: page 1]
