electrocifiligrama/ASSD-TP3/sigmaDelta/simSallenKey.asc

C1: cap; {mc(1n, tolc)}
C2: cap; {mc(1n,tolc)}
R1: res; {mc(1k,tolr)}
R2: res; {mc(1k,tolr)}
R3: res; {mc(10k,tolr)}
R4: res; {mc(10k,tolr)}
U1: opamp2; TL082
U2: opamp2; TL082
U3: opamp2; TL082
V1: voltage; 15
V2: voltage; 15
V3: voltage; ""; AC 1
Named nets: 0, +vcc, -vcc
.ac dec 1000 100 100k
.param tolr=0.05
.param tolc=0.1
.inc TL082.MOD
.step param run 1 100 1
