electrocifiligrama/ASSD-TP3/offset/sim.asc

D2: diode; 1N4148
D3: diode; 1N4148
R1: res; 4.7k
R2: res; 4.7k
R3: res; 4.7k
R4: res; 4.7k
R5: res; 4.7k
R6: res; 4k7
U1: opamp2; TL082
U2: opamp2; TL082
V1: voltage; 15
V3: voltage; 15
V4: voltage; SINE(0 1 1k)
V5: voltage; 5
V6: voltage; 5
Named nets: vcc, 0, -vcc, menos5, vin, mas5, vout
.inc C:\\Users\\lugfe\\Documents\\LTspiceXVII\\lib\\sub\\TL082.301
.tran 0 10m 0
