electrocifiligrama/ASSD-TP3/(list of files, drawings)

Other design files:
librerias altium/Imported ADC0809CCN.lia/ADC0809CCN.PcbLib
librerias altium/Imported ADC0809CCN.lia/ADC0809CCN.SchLib
librerias altium/Imported DAC0800.lia/DAC0800.PcbLib
librerias altium/Imported DAC0800.lia/DAC0800.SchLib
librerias altium/LM7805/Imported (1) LM7805.lia/LM7805.PcbLib
librerias altium/LM7805/Imported (2) LM7805.lia/LM7805.PcbLib
librerias altium/LM7805/Imported (2) LM7805.lia/LM7805.SchLib
librerias altium/LM7805/Imported LM7805.lia/LM7805.PcbLib
librerias altium/LM7805/Imported LM7805.lia/LM7805.SchLib
Placa_ADA/ADA.PcbDoc
Placa_ADA/ADC.SchDoc
Placa_ADA/filtro2.SchDoc
Placa_ADA/filtro.SchDoc
Placa_ADA/History/ADA.~(9).PcbDoc
Placa_ADA/History/ADA.~(22).PcbDoc
Placa_ADA/History/ADA.~(25).PcbDoc
Placa_ADA/History/ADA.~(35).PcbDoc
Placa_ADA/Leds.SchDoc
Placa_ADA/offset.SchDoc
Placa_ADA/Placa_ADA.PrjPcb
Placa_ADA/Placa_ADA.SchDoc
sigmaDelta/sigmaDeltaAltium/clock.SchDoc
sigmaDelta/sigmaDeltaAltium/diferenciator.SchDoc
sigmaDelta/sigmaDeltaAltium/FAAFR.SchDoc
sigmaDelta/sigmaDeltaAltium/integrator.SchDoc
sigmaDelta/sigmaDeltaAltium/integratorLoop.SchDoc
sigmaDelta/sigmaDeltaAltium/sigmaDelta.PcbDoc
sigmaDelta/sigmaDeltaAltium/sigmaDeltaAltium.PrjPcb
sigmaDelta/sigmaDeltaAltium/sigmaDeltaAUX.PcbDoc
sigmaDelta/sigmaDeltaAltium/sigmaDeltaComplete.SchDoc
sigmaDelta/sigmaDeltaAltium/voltageRegulator.SchDoc
