electrocifiligrama/ASSD-TP3/(commit log)

2019-05-16 Segui con el informe
2019-05-18 un poquito mas de informe. Ya llegue a frecuencia de clock minima
2019-05-20 Hice el modulo de clock variable
2019-05-25 Hice la logica del modulador delta
2019-05-25 Hice el mux que elige que conversor va a la salida
2019-05-25 Empeze el esquematico del ADC
    [ADC.SchDoc, Placa_ADA.PrjPcb, Placa_ADA.SchDoc]
2019-05-26 Hice el bloque de leds y switches
    [ADC.SchDoc, Leds.SchDoc, Placa_ADA.PrjPcb, Placa_ADA.SchDoc]
2019-05-26 Empece a conectar bloques de la ADA
    [ADC.SchDoc, Leds.SchDoc, Placa_ADA.SchDoc]
2019-05-26 Falta DAC y SH en bloque de ADC
    En el esquematico de la ADA faltan:
    -Filtros(FA y FR)
    -Bloque de Offset
    -DAC a la salida
    -Conectar bien el DAC en el bloque ADC
    -Meter S&H en el bolque ADC (Tambien hay que meter un jumper)
    -Meter ADC integrado.
    -Capacitores de desacople
    [ADC.SchDoc, Placa_ADA.SchDoc]
2019-05-28 Trate de poner el DAC y fracase como el mejor
    [ADC.SchDoc]
2019-05-28 agrego sample and hold
    [ADC.SchDoc, Placa_ADA.SchDoc]
2019-05-30 altium filtros y offset
    [filtro.SchDoc, offset.SchDoc]
2019-05-30 caja altium filtro y offset
    [Placa_ADA.SchDoc, filtro.SchDoc]
2019-05-30 reguladores de tension y bornera de salida de altium
    [Placa_ADA.SchDoc]
2019-05-30 detalle artistico ah RE
    [Placa_ADA.SchDoc, offset.SchDoc]
2019-06-01 Arregle el ADA,offset y leds
    [ADC.SchDoc, Leds.SchDoc, Placa_ADA.SchDoc, offset.SchDoc]
2019-06-01 separo filtros
    [Placa_ADA.PrjPcb, Placa_ADA.SchDoc, filtro.SchDoc, filtro2.SchDoc]
2019-06-01 Revert "ff"
    This reverts commit 775e54c2a6161a6b8657a8b4ef6931f73484cb40.
    [filtro.SchDoc]
2019-06-01 arreglo conexiones malas
    [Placa_ADA.SchDoc]
2019-06-02 Falta meter el ADC integrado
    [Placa_ADA.SchDoc, filtro.SchDoc, filtro2.SchDoc]
2019-06-02 Meti el chip del ADC, queda revisar y routear
    [Placa_ADA.SchDoc]
2019-06-02 mejoras altium
    [Placa_ADA.SchDoc]
2019-06-02 alimentaciones arregladas
    [Placa_ADA.SchDoc, filtro.SchDoc]
2019-06-02 Arregle la entrada del integrado ADC
    [Placa_ADA.SchDoc]
2019-06-02 SIIII LARROQUEEEEE
    [Placa_ADA.SchDoc]
2019-06-02 librerias altium
    [LM7805.PcbLib, LM7805.SchLib]
2019-06-02 esquematico finito
    [ADA.PcbDoc, ADC.SchDoc, Leds.SchDoc, Placa_ADA.PrjPcb, Placa_ADA.SchDoc]
2019-06-04 routeo terminado
    [ADA.PcbDoc, ADA.~(22).PcbDoc, ADA.~(25).PcbDoc, ADA.~(35).PcbDoc, ADA.~(9).PcbDoc, ADC.SchDoc, ADC0809CCN.PcbLib, ADC0809CCN.SchLib]
2019-06-05 se sube sigma delta, falta terminar informe
    [FAAFR.SchDoc, clock.SchDoc, diferenciator.SchDoc, integrator.SchDoc, integratorLoop.SchDoc, sigmaDelta.PcbDoc, sigmaDeltaAUX.PcbDoc, sigmaDeltaAltium.PrjPcb]
2019-06-05 Agregue modulos de verilog
2019-06-05 Parece que todos los modulos de verilog funcan
2019-06-05 Empece el quartus que une los modulos
2019-06-05 se avanza con el informe SIGMA DELTA
2019-06-05 avances con el informe SIGMA DELTAAAA
2019-06-06 En teoria ya esta el quartus
2019-06-12 Tratte de simular la ADA
2019-06-13 se sube la simulacion de simulink
2019-06-14 Termine el informe
2019-06-15 se borra seccion de s&h y conversor de modulador delta
2019-06-17 Arregle una boludez de quartus
    [PllOriginal_altpll.v, PseudoPLL.v]
2019-06-23 Cambie el bloque de newstart
